Salmon10k/Pocketpet.esp32c3/Simulations/fluid 1.webp

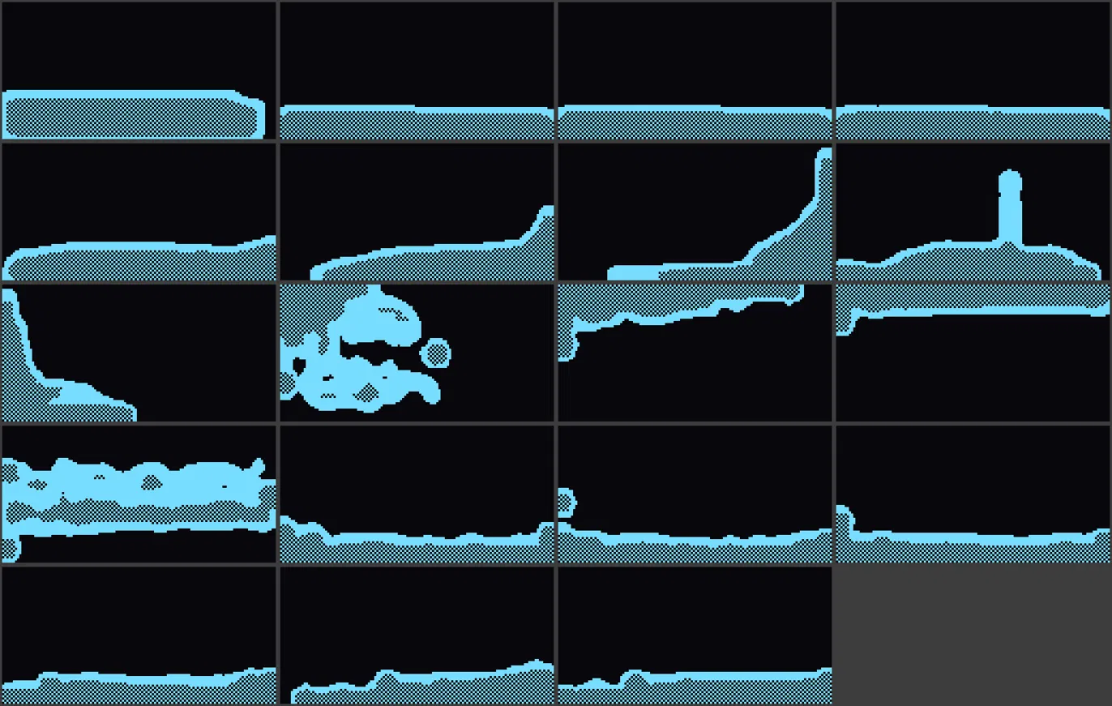
Simulations/fluid 1.webp
