Salmon10k/Pocketpet.esp32c3/Simulations/fluid 3.webp

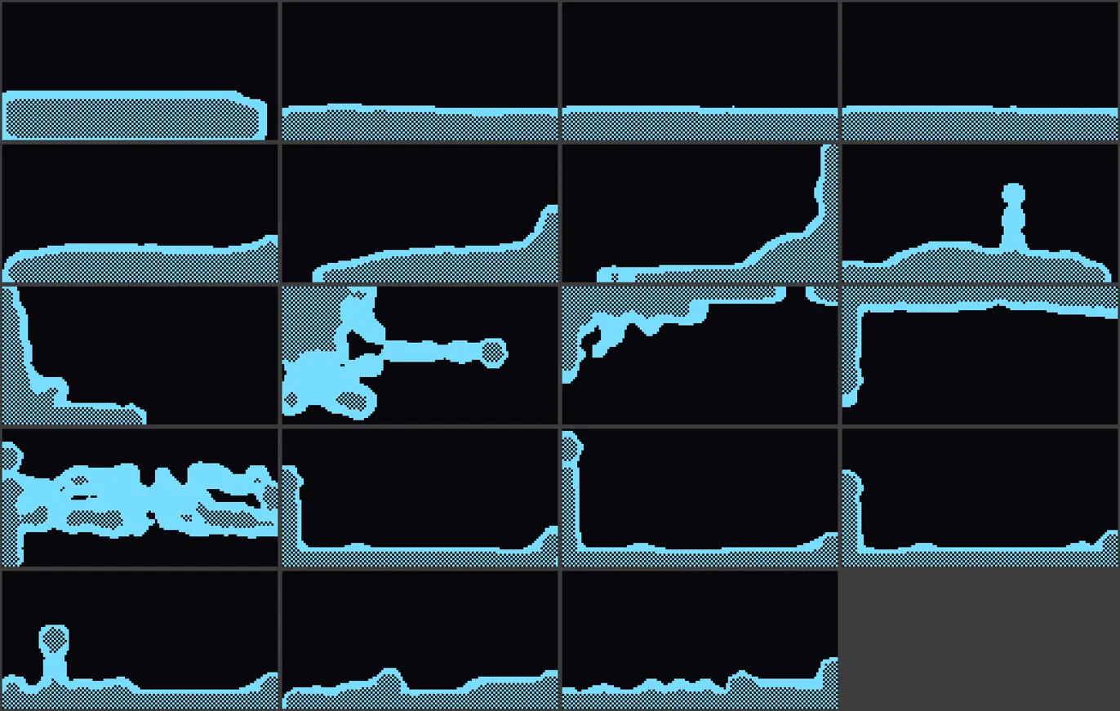
Simulations/fluid 3.webp
