Salmon10k/Pocketpet.esp32c3/README.md

# Pocketpet.esp32c3

> **Status (2026-11-14): active again, in small steps.** The project was paused on 2026-10-30 and picked back up
> for the games/menu revamp (11-12) and a repo review (11-14). A lot of the firmware on `main` (Online, Spotify,
> Lyrics visual, games, launcher) is still **not fully tested on the device**, and the custom PCB is designed but
> not finished or ordered (`PCB/` holds the KiCad project only). See `HANDOFF.md` for the details.
> Do not start big new features unless Salman asks.

Keychain-sized digital pet gadget built around an ESP32-C3 Super Mini with a 1.3" SH1106 OLED, MPU6050 motion sensor, touch input and three buttons.

## Current hardware wiring

**Important:** the OLED and MPU6050 share **one hardware I2C bus (`Wire`)** on GPIO 8 (SDA) and GPIO 9 (SCL), 400 kHz. They have different addresses (OLED `0x3C`, MPU6050 `0x68`), so they coexist on the same two wires. (Until 2026-11-09 the MPU6050 was on its own software I2C bus on GPIO 5/6; that is gone and GPIO 5/6 are free.)

| Part | Pin | ESP32-C3 GPIO | Notes |
|---|-----|---|---|
| OLED SH1106 + MPU6050 | SDA | **8** | Shared hardware I2C, 400 kHz |
| OLED SH1106 + MPU6050 | SCL | **9** | Shared hardware I2C, 400 kHz |
| Button A | one leg to GND | **2** | Up / previous / tickle |
| Button B | one leg to GND | **1** | Select / back |
| Button C | one leg to GND | **0** | Down / next / boop |
| Touch pad | OUT | **4** | TTP223-style, HIGH when touched (the pin next to 3V3) |

Wire the MPU6050 SDA/SCL to the same GPIO 8 / 9 pins as the OLED.

### I2C addresses
- OLED: `0x3C`
- MPU6050: `0x68`

### GPIO notes
- GPIO 8 and GPIO 9 are ESP32-C3 strapping pins (they are also the C3's default I2C pins). The OLED has been tested on them. If the board ever becomes unreliable during boot, investigate these pins first.
- GPIO3 is the only free ADC1 pin left. Keep it for the battery voltage divider.
- GPIO 0-5 can wake the C3 from deep sleep, so the touch pad (GPIO4) and buttons (0, 1, 2) all work for wake-up later.

## Current firmware

### Home and menu
The **pet is the home screen**: it is what you see when the keychain turns on and where it returns to when you leave it alone (the launcher goes back to the pet after 20 s without input; holding B in the launcher also goes home). **Press B on the pet** to open the launcher, which has two styles you pick in **Settings > Menu style**:
- **Carousel** (default): big icons slide in from the right; **A** = previous, **C** = next, **B** = open.
- **Tilt ring**: the apps sit on a ring; **tilt the keychain toward an app** to highlight it, **B** opens it (A/C also step through them).

In the launcher: Fluid, Stats, Motion test, Tools, Games, Online, Spotify, Visualizer (Lyrics visual), Living OLED, Settings. While it starts, the MPU6050 calibrates itself in the background (gyro offsets, and which way is "down" from gravity), so tilt works however the sensor sits on the board and however you hold the keychain; in Pet mode it re-levels itself when you hold it still in a new pose. Every sub-menu (Tools, Games, Settings and the Online list) uses the same carousel / tilt-ring look as the home screen: **A/C** move, short **B** opens, **hold B** goes up one level, and each one ends with a **Back** item. Settings shows the current value in a pill under the name (brightness, screen auto-off, flip screen, menu style, lyrics sync, reset pet); Games shows your best score. Tools contains Temperature, Magic 8-ball and Dice (shake the keychain to roll / ask).

### Games
Built for the three buttons and the MPU6050. Best scores are saved.

| Game | Controls |
|---|---|
| **Star Blaster** (side-scrolling shooter: drones, gunships, splitting rocks, power-ups) | tilt flies the ship, **A** shoots (hold = rapid fire), **C** = smart bomb |
| **Sniper** (night city, scope with sway; enemies pop up in windows, survive 3 misses) | tilt swings the scope, **A** fires (bolt action), hold **C** to steady your breath and zoom 2x |
| **Road Rush** (pseudo-3D racer, beat the clock, checkpoints add time) | tilt steers (bends push you outwards), **A** nitro, **C** brake |
| **Pinball** (the table lies on its side, flippers on the right edge) | **A** upper flipper, **C** lower flipper, shake the keychain to nudge the ball (nudge too much = TILT) |
| **Tilt Maze** | tilt, **A** re-zero, **C** new maze |
| **Snake** | tilt to steer (or **A** left / **C** right) |

Online has 12 screens that need the internet (see below). Copy `src/secrets.example.h` to `src/secrets.h` and set `WIFI_SSID` / `WIFI_PASSWORD` locally first. The touch pad only works in Pet mode.

### Online mode
Wi-Fi stays **off** everywhere except Online mode. Entering Online connects **once** (up to 3 automatic attempts, then each request is retried up to 3 times for random network hiccups), fetches everything for every screen in one go, and stays connected while you browse. Leaving Online switches the radio off. The list header shows the state: `wifi 2/3`, `sync 4/9`, `online`, `offline`. Every screen shows how old its data is (top right). If a refresh fails you keep the last good data.

**Several Wi-Fi networks:** list them in `secrets.h` with `WIFI_NETWORKS` (see `src/secrets.example.h`), for example home, uni and your phone hotspot. On entering Online it scans, tries the strongest known network first and falls back to the others by itself. Net status shows which one it picked. 2.4 GHz networks only.

Controls: in the list, A/C move and B opens (**Sync now** refetches everything, **Back** leaves). On a screen, **A = refresh this screen** (no reconnect), **C = next screen**, **B = back to the list**, touch = Home.

| Screen | Source (no API keys) | Refreshes |
|---|---|---|
| Clock | NTP (`pool.ntp.org`), keeps ticking offline | synced on connect, resync every 6 h |
| Weather | Open-Meteo | 30 min |
| Forecast | same request as Weather | 30 min |
| Air quality | Open-Meteo air quality (US AQI, PM2.5) | 30 min |
| Currency | open.er-api.com (USD to `CURRENCY_HOME`, EUR, GBP) | 6 h |
| World clocks | computed from NTP time, with DST rules for London, New York, Tokyo, Sydney | no request |
| Random fact | uselessfacts.jsph.pl | once per visit, A = new one |
| Advice | adviceslip.com | once per visit, A = new one |
| Moon phase | calculated from the date (approximate, within about a day) | no request |
| Net status | RSSI, IP, a `generate_204` check with ping time | every 20 s while open |
| ISS tracker | api.open-notify.org (plain HTTP) | every 60 s while open |
| GitHub | api.github.com stars, forks, issues, last push | 10 min |

Location for weather and air quality comes from an IP lookup (ip-api.com) unless you set `LOCATION_LAT` / `LOCATION_LON` in `secrets.h`. See `src/secrets.example.h` for all optional overrides.

**Pet reactions:** when cached data exists, Pet mode shows tiny corner icons: sweat drop (35 C or hotter), umbrella (rain chance 60% or more), cloud (AQI 150 or more), moon (after sunset). Each successful fetch also gives the pet a small happiness bump.

Requests are blocking with a 7 second timeout, so the screen can pause briefly while one runs. A progress frame is drawn first so it never looks frozen. Background refresh while you are in Online: weather and air quality every 30 min, currency 6 h, GitHub 10 min. Net status and ISS only refresh while you are looking at them.

**Connection problems:** many ESP32-C3 Super Mini boards fail to connect at full TX power, so the firmware lowers it to 8.5 dBm by default. If your router is far away and the signal is weak, put `#define WIFI_TX_POWER WIFI_POWER_11dBm` (or `WIFI_POWER_19_5dBm`) in `src/secrets.h`.

### Spotify mode
Shows what is playing on your Spotify (any device: phone, PC, speaker), with **synced lyrics** from LRCLIB, and controls it: **A** previous, **B** play/pause, **C** next. **Hold B** (0.7 s) = back to the menu. The screen stays on while you are in this mode. Needs Spotify **Premium** for the buttons (viewing works without) and the Wi-Fi from `secrets.h`. Spotify itself must be playing somewhere; the keychain is a remote, not a speaker.

One-time setup (on your PC):
1. https://developer.spotify.com/dashboard -> Create app (any name, Web API). Add the Redirect URI exactly `http://127.0.0.1:8888/callback`. Copy the Client ID.
2. `python tools/spotify_auth.py YOUR_CLIENT_ID --write` (opens a Spotify login page, then writes `SPOTIFY_CLIENT_ID` and `SPOTIFY_REFRESH_TOKEN` into `src/secrets.h`, which Git ignores).
3. Build and flash. If it says the login expired (about every 6 months), run step 2 again.

Notes: Spotify apps in development mode need the app owner to have Premium and allow 5 users, which is plenty for one keychain. The screen can freeze for about a second when a song changes (a new secure connection for the lyrics), that is normal. Not every song has synced lyrics; those show the title and artist instead.

### Fluid mode
Particle water simulation that follows tilt. Hold the device like a phone, it calibrates for half a second (that pose counts as level). A = re-zero, C = Water / Honey / Mercury, B = back.

### Pet mode (companion style, nothing can die)
- Eyes ease smoothly between moods, blink on their own, sometimes double-blink or wink, and wander around when idle.
- Pupils follow tilt from the MPU6050.
- **Moods:** neutral, happy, sad (when ignored), sleepy (low energy or no activity for 30 s), asleep (no activity for 60 s, with floating Zzz).
- **Touch:** tap = love face and hearts. Hold the pad for 0.6 s = purr, which keeps raising happiness.
- **Motion:** shake = dizzy spiral eyes (and a small happiness drop). A sharp pickup, bump or drop = surprised.
- **Buttons in Pet mode:** A = tickle (laughs), C = boop (surprised), B = back to the menu.
- Any touch, button press or movement wakes it up.
- **Music pet (Settings > Music pet, default On):** while Spotify is playing, Pet mode quietly opens a Spotify session (Wi-Fi, so it costs battery; it drops when the screen turns off or you leave Pet mode) and the pet dances to the song. The reaction depends on the vibe: **Chill** (eyes closed, headphones, slow sway), **Pop** (happy eyes, bounce, notes and sparkles), **Hype** (shades, head nods, impact lines), **Rock** (angry eyes, headbang, lightning), **EDM** (big pulsing pupils, equalizer, strobe on the bar), **Desi** (dreamy eyes, wide sway, hearts), **Dreamy** (starry eyes, twinkles). The mouth flaps on sung words. The vibe name flashes briefly when a track starts; a trailing **?** means it was guessed (no genre data) from the title and lyric speed. The beat is a steady feel-tempo per vibe locked to the song position, not the song's real BPM (Spotify no longer gives tempo).

### Stats
Happiness and energy are saved to flash (about every 2 minutes when they changed, and when leaving Pet mode), so the pet remembers across reboots. The Stats screen shows both bars and a lifetime pet count. **A or C flips it to a System page** with the numbers that matter for debugging: FPS (frames sent to the OLED, capped at 25), how often `loop()` runs, free heap, lowest free heap since boot, the largest free block (the real limit for a TLS connection), app size, uptime and why the chip last restarted. Open it before and after using Online or Spotify to see how much heap they eat.

### Other
- Button debouncing with press events.
- MPU6050 and OLED are re-checked every 2 seconds and recover if they drop out.
- Serial diagnostics once a second (buttons, touch, OLED, MPU, happy, energy, pets, fps, free / min heap and largest free block in KB).
- GitHub Actions (`.github/workflows/build.yml`) builds the firmware with PlatformIO on every push and shows the RAM / flash usage in the run summary.

## Build

1. Install PlatformIO in VS Code.
2. Open this folder (it will download U8g2 and ArduinoJson).
3. Plug the ESP32-C3 Super Mini in with a data-capable USB cable.
4. Build and upload with PlatformIO.
5. Board environment: `esp32-c3-supermini`.
6. USB CDC on boot is enabled in `platformio.ini`.
7. `partitions.csv` gives the app a 3 MB slot (no OTA) because Wi-Fi + TLS made the firmware too big for the default 1.3 MB slot.

## Files
- `src/main.cpp` -> main firmware and pet logic
- `src/online.h` / `src/online.cpp` -> Online mode (Wi-Fi state machine, request cache, the 12 screens)
- `src/vibe.*` -> genre to vibe classification, feel-tempo, energy (pure C++)
- `src/pet_face.*` / `src/pet_music.*` -> pet eyes and mouth drawing; per-vibe dance poses and decorations
- `src/spotify.h` / `src/spotify.cpp` -> Spotify mode (token refresh, now playing, controls, LRCLIB lyrics)
- `tools/spotify_auth.py` -> one-time Spotify login helper (PC)
- `src/config.h` -> all GPIO assignments, I2C addresses and pet tuning
- `platformio.ini` -> PlatformIO build configuration
- `partitions.csv` -> flash layout (one 3 MB app slot)

When changing wiring, update `src/config.h` first.

## First-flash checklist
- [ ] Builds and uploads
- [ ] OLED shows the menu (serial boot log says "OLED found")
- [ ] Serial shows `mpu=1`
- [ ] `touch=` flips to 1 when the pad is touched
- [ ] Eyes follow tilt the right way (if not, flip `TILT_X_SIGN` / `TILT_Y_SIGN` in `config.h`)
- [ ] Shake gives dizzy eyes, sharp pickup gives surprised eyes

## Status
- [x] Repo + starter project
- [x] OLED confirmed working (SH1106, GPIO 8/9)
- [x] Touch pad soldered on, signal on GPIO4
- [x] I2C roles swapped: OLED on hardware I2C, MPU6050 on SoftWire (superseded 2026-11-09: both now share the hardware bus on GPIO 8/9)
- [x] Improved pet mode: moods, eased eyes, touch petting, motion reactions, sleep, hearts, Zzz
- [x] Stats screen with flash-saved happiness and energy
- [x] Verify current firmware on hardware
- [ ] Try the RoboEyes library for the eyes (optional, only if the current look is not liked)
- [x] Temperature mode
- [x] Game mode (Magic 8-ball + Dice)
- [x] Games (Star Blaster, Sniper, Road Rush, Pinball, generated Tilt Maze, tilt Snake)
- [x] Touch pad (Pet mode only)
- [x] Optional Wi-Fi NTP clock (credentials must be configured locally in ignored `src/secrets.h`)
- [x] Wi-Fi NTP clock
- [x] Online mode: weather, forecast, AQI, currency, world clocks, fact, advice, moon, net status, ISS, GitHub (in code, host-checked, not yet tested on the device)
- [ ] Pet sleeps at night
- [ ] Battery monitoring (GPIO3 divider)
- [ ] Deep sleep / wake on touch

## Notes for future development

> **OLED + MPU6050 share one hardware I2C bus on GPIO 8 (SDA) / 9 (SCL).**

If another developer or AI agent continues this project, read `src/config.h` and this README before changing pin assignments or the bus setup. The pet logic is separated from the drawing: `currentFace()` decides the mood, `faceParams()` maps a mood to eye/mouth targets, and `drawPet()` eases toward them.

## Work completed today (2026-10-10)

Today’s development session focused on expanding the games and preparing the online clock feature:

- **Tilt Maze:** planned/prototyped a procedural maze system, with randomized maze generation, solvable layouts, reversed left/right tilt behavior, and a 45° forward-facing MPU6050 neutral angle.
- **Dino Runner:** expanded the design with jump/crouch controls, additional obstacle types, flying obstacles, and more polished movement/animation.
- **Online clock:** added the Wi-Fi/NTP clock direction, including local credential handling through the ignored `src/secrets.h` file and an example template at `src/secrets.example.h`.
- **Documentation:** updated the handoff notes and README to record the work from this session.

**Hardware status:** these new changes were not fully hardware-validated today. The existing Batch 1 hardware features remain the known-tested baseline. Do not treat the new maze, Dino upgrades, or Wi-Fi clock as hardware-confirmed until they are built, flashed, and tested on the device.
