Salmon10k/Pocketpet.esp32c3/HANDOFF.md

# HANDOFF: read this first if you are an agent (or human) continuing the project

## Project paused (2026-10-30), active again in small steps (2026-11-12 and 2026-11-14)
Salman paused the project. On 2026-11-12 he asked for a games + menus revamp (see "Games and menu revamp" at the
bottom); that is done in code and host-tested, not yet flashed. On 2026-11-14 he asked for a repo review and for the
small quick fixes first (see "Review fixes 2026-11-14" at the bottom). Do not start big new features or refactors
unless he asks; he is choosing from a list of ideas (battery gauge, night sleep, deep sleep, ...).

**State when paused**
- Firmware on `main` (last commit before the pause: `b2318d5`, word timing in lyric lines). Hardware is the
  protoboard build (ESP32-C3 Super Mini, SH1106 OLED, MPU6050, touch pad, three buttons). The TP4056 charger
  module was found faulty (0.45 V drop under load), so the battery was not reattached; a protected
  replacement was still to be bought.
- Tested on the device: pet mode, stats, I2C swap, touch, Temperature, Magic 8-ball, Dice.
- Written and host-checked only, never confirmed on hardware (see the Status table and the per-feature notes
  below): Online mode, Spotify mode and its lyric worker, Lyrics visual, Quick connect, Wi-Fi fixes,
  Urdu/Arabic lyrics, word timing, Snake, Tilt Maze, Fluid, Settings, the new games and launcher. (Flappy, Dino Runner
  and Catch Water were removed on 2026-11-12.)
  The `feature/lyrics-visualizer` branch history is described below; check `git branch -a` before assuming
  it was merged.
- Custom PCB: a ghost-shaped KiCad board was designed but is not finished or ordered. NOTE (2026-11-14): the
  `pcb/README.md` that used to describe it (outline SVG, KiCad placement script, layout coordinates and a list of
  schematic problems, including the battery connector wired to the wrong net) is NOT in the repo any more; `PCB/`
  only holds the raw KiCad files (`PCB.kicad_sch/pcb/pro/prl`). Check the schematic's battery connector net before
  ordering anything.
- Not started: battery monitoring (GPIO3 divider), deep sleep with wake on touch, Pomodoro/Stopwatch,
  Spirit level, Step counter, pet sleeps at night.

**To resume**
1. Ask Salman what he wants first. The safest start is to build with PlatformIO, flash, and report the
   serial log and memory numbers for the untested modes.
2. For the PCB, open `PCB/PCB.kicad_pro` in KiCad (the old `pcb/README.md` notes are gone, see above).
3. Keep the rules below (do not change pins, keep the pet animation code, no secrets in the repo).

Owner: Salman (GitHub: Salmon10k). Student, new to soldering, builds on a protoboard, flashes with
PlatformIO in VS Code on Windows. He tests on the real device and reports back, so keep instructions short
and concrete. Casual tone is fine and preferred. He is on a free Claude plan with limited usage, which is
why this file exists.

## What this is
Pocketpet: a keychain-sized ESP32-C3 Super Mini gadget with a 1.3" SH1106 128x64 mono OLED, MPU6050
(accel/gyro/temp), a TTP223 touch pad, 3 buttons and a battery. Main feature is an animated pet; more
"modes" (tools, games, WiFi clock) are being added around it.

## Hardware map (source of truth: `src/config.h`)
| Part | GPIO | Notes |
|---|---|---|
| OLED + MPU6050 SDA/SCL | 8 / 9 | ONE shared HARDWARE I2C bus (`Wire`), 400 kHz; OLED 0x3C (U8g2 `..._F_HW_I2C`), MPU6050 0x68 (raw register reads). Changed from separate buses (MPU on SoftWire GPIO 5/6) on 2026-11-09 at Salman's request; GPIO 5/6 are now free. |
| Button A / B / C | 2 / 1 / 0 | to GND, internal pull-up, active LOW. Matches `config.h` (docs used to say A=0, C=2; fixed 2026-11-14, Salman should confirm on the board) |
| Touch pad OUT | 4 | HIGH when touched |
| Free ADC pin | 3 | reserved for the battery voltage divider |

Do NOT change the bus layout or pins without asking Salman: the board is soldered, rewiring is painful.
GPIO 8/9 are strapping pins, GPIO 0-5 are the only deep-sleep wake pins on the C3.

## Source layout
- `src/config.h`: pins, addresses, timing and tuning macros.
- `src/online.h` / `src/online.cpp`: the whole Online mode. Own state (Wi-Fi state machine, per-request cache, 12 screens). main.cpp only calls `online::enter/leave/tick/input/draw/drawPetBadge/takeTreats`. See "Online mode" below.
- `src/spotify.h` / `src/spotify.cpp`: Spotify mode (MODE_SPOTIFY, root menu index 7). Borrows the radio from online.cpp through `online::wifiAcquire/wifiRelease/wifiUp/wifiStatusText`; online's tick drives the connection while `wifiHold` is set, but runs no jobs unless `session` (Online mode) is open.
- `src/vibe.h/.cpp` (pure C++), `src/pet_face.h/.cpp` (eye/mouth drawing moved out of main.cpp), `src/pet_music.h/.cpp` (poses + decor per vibe): the Music pet. Tools: `tools/vibetest/` (248 checks), `tools/petpreview/` (real face on PC + ASan torture). See "Music pet" below.
- `tools/spotify_auth.py`: PKCE login helper run on the PC, writes SPOTIFY_CLIENT_ID / SPOTIFY_REFRESH_TOKEN into secrets.h.
- `src/games.h` / `games.cpp`: Star Blaster, Sniper, Road Rush, Pinball (self-contained; main.cpp hands in an `Input` struct with buttons, calibrated tilt and shake, and owns the tilt calibration).
- `tools/gamepreview/`: PC harness (real U8g2 on the PC) that renders menus/games to PNG sheets, runs scripted "AI players" and a sanitizer fuzz test. See "Games and menu revamp".
- `src/launcher.h` / `launcher.cpp`: the home menu AND every sub-menu (carousel + tilt ring, `enterSub()` with any item list, optional value pill), 37 procedural icons (`drawIcon`, any size/animated), selection state. Pure UI: main.cpp starts the apps. `src/gfx.h` / `gfx.cpp`: clipped primitives (px/line/circle/disc/arc/rframe...) that are safe at any coordinate (U8g2 coordinates are unsigned 8-bit).
- `src/main.cpp`: current firmware, hardware init, input handling, MPU, stats, pet animation/drawing, menus and mini-games, shared tilt helper, Tilt Maze, Fluid glue.
- `src/fluid.h` / `src/fluid.cpp`: fixed-point particle fluid (no Arduino deps, also compiled on PC by `tools/fluidtest/`).
- `tools/fluidtest/`: host harness (`fluidtest.cpp` + `render.py` PNG contact sheets) for tuning the fluid without hardware.
- `src/config.h`: hardware pins and tuning.
- The firmware is currently monolithic in `main.cpp`; do not assume the planned screen-registry/multi-file architecture exists yet.
- `README.md`: user-facing docs. Keep it in sync when behaviour changes.

## Architecture: screens
Current implementation uses a `Mode` enum and dispatches input/drawing in `main.cpp`. The menu tree has root, Tools, Games and Online. Rules:
- Modes draw into the shared `display` buffer; the main loop does `clearBuffer()` / `sendBuffer()`.
- Convention: **B = back/exit**, A and C are actions. The touch pad acts as Home outside Pet mode.
- Anything that must keep running outside its screen (Pomodoro timer, step counting, WiFi state machine)
  has a `xxxTick(now)` function that the main loop calls every iteration.
- Use `notify("text", ms)` for a banner shown over any screen (e.g. "Pomodoro done").
- Never block the loop for long. The only accepted blocking call is the weather HTTP GET (short timeout).
- Pet stats are changed through `petAddHappy()` / `petAddEnergy()`, never directly from other files.

## Conventions
- Companion pet: nothing can die, stats are floored. Do not add punishing mechanics.
- Flash saves go through `Preferences` ("pocketpet" namespace), throttled. Do not write to flash in a loop.
- No secrets in the repo (the repo is public). WiFi credentials and the user's coordinates live in
  `src/secrets.h`, which is gitignored; `src/secrets.example.h` is the template. Never commit `secrets.h`.
- Commit messages in this repo end with the Co-Authored-By / session trailers the harness asks for.
- Memory numbers: the first pet version was RAM 4.9%, flash 23.1% of the default 1.3 MB app slot. After Online mode (Wi-Fi + TLS + ArduinoJson) Salman reported about 21% flash left, i.e. roughly 79% used of the 1.3 MB slot. So `platformio.ini` now uses `partitions.csv` (one 3 MB app slot, no OTA, nvs at the same address so saved stats survive). The first upload after that change rewrites the partition table. Serial prints one `flash: app ... heap free ...` line in the boot log and a heap line after each Online sync: ask Salman for those numbers before deciding to cut features. Latest build (2026-11-14, PlatformIO summary): RAM 31.7% (103,772 of 327,680 bytes, static), flash 36.0% (1,133,192 of 3,145,728 bytes). Runtime heap is on Stats > System (press A on Stats) and in the serial status line.

## Testing (important)
- In the agent sandbox PlatformIO cannot download the ESP32 toolchain, so NOTHING can be compiled for the
  chip there. Run `tools/hostcheck/check.sh` instead (it has mock WiFi.h too): it syntax-checks every `src/*.cpp` against mock Arduino
  headers plus the real U8g2 / ArduinoJson headers. Passing means "no typos / API mismatches",
  not "works on the board".
- Salman builds with PlatformIO (check mark), flashes (arrow) and watches Serial Monitor at 115200.
  Ask him for build output / serial log when something fails. Each batch of work should end with a short
  "what to test on the device" list for him.
- Serial prints a status line every second (buttons, touch, oled, mpu, happy, energy, pets).

## Status
Update this section as you work. Mark things DONE only after the host check passes; mark TESTED only after
Salman confirms on the device.

| Item | State |
|---|---|
| Pet mode (moods, touch, shake, sleep), Stats, Motion test | DONE and TESTED (Salman: "looks good") |
| I2C swap (OLED hw, MPU soft), touch on GPIO4 | DONE and TESTED. SUPERSEDED 2026-11-09: both now on one hardware bus GPIO 8/9 (host-checked only, not yet flashed) |
| Expanded root/Tools/Games/Online menus | DONE (monolithic implementation) |
| Temperature, Magic 8-ball, Dice | DONE and TESTED (Salman confirmed) |
| Games: Star Blaster, Sniper, Road Rush, Pinball (games.cpp), tilt Snake, Tilt Maze; Flappy / Dino / Catch Water removed | DONE in code + host-checked + PC-rendered + fuzzed (2026-11-12); needs Salman hardware confirmation |
| Tools / Games / Settings / Online list in the launcher look (carousel or tilt ring, Back item, value pills) | DONE in code + PC-rendered; needs hardware confirmation |
| Fluid main mode (root menu item 2), 3 presets | DONE in code + host-checked + host-rendered; needs Salman hardware confirmation (FPS, tilt feel) |
| Tilt Maze rewrite (fixed 20 ms physics, shared tilt helper) | DONE in code + host-checked; needs hardware confirmation |
| Pomodoro + Stopwatch | TODO (batch 3) |
| Online mode (12 screens: Clock, Weather, Forecast, Air quality, Currency, World clocks, Fact, Advice, Moon, Net status, ISS, GitHub) | DONE in code + host-checked; needs Salman hardware confirmation (never compiled for the chip) |
| Pet corner badges from Online data (hot, rain, smog, night) | DONE in code, needs hardware confirmation |
| Pet sleeps at night | TODO (Online already stores `is_day`, see `online::petHint()`) |
| Spirit level, Step counter | TODO (batch 5) |
| BLE shutter remote | SKIPPED by Salman for now (do not build unless asked) |
| Battery monitoring (GPIO3 divider), deep sleep + wake on touch | NOT STARTED, needs hardware first |

## Currently working on
Online mode just landed (host syntax check passes, nothing compiled for the chip or flashed). Next: Salman flashes it and reports, then Pomodoro/Stopwatch, Spirit level, Step counter.

### Online mode (online.cpp)
- **Items vs jobs.** 12 screens ("items") map to 10 network "jobs" (geo, weather, aqi, currency, fact, advice, net, iss, crew, github). Forecast reuses the weather job; Clock/World/Moon only need NTP time.
- **Radio policy: ONE session per visit.** `enter()` queues every job (`queueSync`) and connects once; `leave()` switches the radio off. Nothing else touches Wi-Fi, and Pet/other modes never turn it on. Networks come from `WIFI_NETWORKS` (several) or `WIFI_SSID/WIFI_PASSWORD` (one) in secrets.h: with several, an async scan runs first (`W_SCAN`) and `buildOrder()` sorts the known ones by signal; each network gets 2 attempts (min 3 total, max 8). Connect attempts are 10 s each with 1 s backoff, `WiFi.setTxPower(WIFI_TX_POWER)` defaults to 8.5 dBm (known fix for flaky C3 Super Mini antennas, overridable in secrets.h). Link drop while in Online reconnects by itself and keeps the queue. `tick()` runs at most one request per call, only after a frame was drawn; transient failures (HTTP <= 0 or >= 500, bad JSON) retry up to 3 times. After the initial sync, `autoRefresh()` re-queues stale jobs every 3 s (Net/ISS only while that screen is open; a failed refresh waits 60 s). Do not add per-screen `WiFi.begin()` calls.
- **Time.** System time is UTC (`configTime(0,0,...)`), then `TZ` is set from `LOCAL_TZ` (default `PKT-5`). Clock keeps ticking with the radio off. World clocks compute offsets with their own DST rules (EU, US, AU). Do not call `configTime` elsewhere with an offset, it resets TZ.
- **Cache.** Each job has `at/has/err/http`. Failed refresh keeps old data and shows `!` in the header tag. Intervals live in `JOB_EVERY[]`.
- **Location.** `LOCATION_LAT/LON/NAME` in secrets.h, else one IP lookup per boot (ip-api.com, HTTP). No city or coordinates are committed.
- **Controls.** List: A/C move, B opens; extra rows "Sync now" (refetch everything) and "Back". Inside a screen: A = refresh that screen's jobs (ignored within 1.5 s of the last one), C = next screen, B = back to list, touch = Home (existing global rule).
- **Pet hook.** `online::petHint()` reads cached data only; `drawPetBadge()` is drawn after `drawPet()` in main.cpp, `drawPet()` itself is untouched. `takeTreats()` gives +1 happiness per completed sync.
- **Known approximations.** Moon phase uses the mean synodic month (can be off by up to about a day). `setInsecure()` TLS. ISS/crew use open-notify (HTTP only, free service, may be down; failure just shows "Couldn't load").

### What Salman should test on the device (Online)
1. Build with PlatformIO (it will download ArduinoJson). Send me the build output if it fails; I could not compile for the chip.
2. Copy `src/secrets.example.h` to `src/secrets.h`, set SSID + password, flash.
3. Online: the list header should go `wifi 1/3` > `sync n/9` > `online`, all with ONE connection. Clock shows PKT time.
4. Weather / Forecast / Air quality: city comes from the IP lookup, values look sane. Press A to refresh.
5. Currency, World clocks (compare with a phone), Moon, Net status (RSSI, IP, ping), ISS dot moves between refreshes, GitHub shows your repo.
6. Fact / Advice: A gives a new one, long ones scroll.
7. With Wi-Fi off or a wrong password: a screen should say "Couldn't load / No Wi-Fi", not freeze.
8. Pet mode after fetching weather: no icon is normal unless it is 35 C+, rainy, AQI 150+ or night.
9. Free heap / flash: check the PlatformIO memory summary after the build and tell the next agent.

### Spotify lyric stutter fix (2026-10-11; not yet hardware-validated)

**Goal:** keep lyric sliding/highlighting animated while Spotify or LRCLIB HTTPS requests are slow. The animation and its drawing algorithm were not changed.

**Exact files changed for this fix**
- `src/spotify.cpp`
  - Added a persistent FreeRTOS task named `spotifyNet` with a 16 KB stack.
  - `spotify::tick()` now queues one of four network jobs: login, now-playing poll, lyric lookup, or playback command. Those HTTPS calls run on `spotifyNet`, not the Arduino loop that draws the OLED.
  - Added a recursive mutex around short shared-state operations and the Spotify draw/input functions. The mutex is not held during HTTP requests.
  - Added a session-generation counter so responses that finish after leaving/re-entering Spotify are discarded.
  - The TLS client is now owned/cleaned up by the worker. `leave()` no longer calls `sec.stop()` while a request could be using the client.
  - Existing lyric animations, timings, fonts, line parsing, poll intervals, credentials, controls, and network endpoints were left as they were.
- `tools/hostcheck/freertos/FreeRTOS.h`, `task.h`, `semphr.h`
  - Added syntax-only mocks for the task and recursive-mutex APIs. They are not real FreeRTOS implementations and do not test scheduling.
- `HANDOFF.md`
  - This rollback/change note only.

**Not changed:** `src/main.cpp`, `src/online.cpp`, `src/spotify.h`, `src/config.h`, README, pin assignments, pet animation code, or secrets.

**Validation status:** source changes are committed, but a PlatformIO ESP32-C3 build and on-device playback test have **not** been run by the agent. Host syntax checks are useful but cannot confirm task stack sizing, heap headroom, Wi-Fi behavior, or race-free playback on hardware. First test: build with PlatformIO, flash, then watch whether lyrics keep animating during a poll and during a track change. If the screen says `Network task unavailable`, the worker task or mutex could not be created.

**Commits in this change**
- Spotify worker/state-locking implementation: `aeea5775ee4005358710d89c6ea9d4e02b13987f`
- Host-check mock headers: `f4208e5f4561731020b57d1535936d9882cb83d3`, `e96ad10dbbe40e473b74e79b94f6b71aff11e7eb`, `0496876a6007b276334382a86e0ff30719d19704`
- Pre-change rollback point: `d94f61cb9bf372f5fc9533e8a86e69632073006f`

**Rollback:** use `git revert --no-edit` on the commits above in reverse order, including the HANDOFF note commit once its SHA is recorded in the commit history. The simplest clean reference for the original animated-lyrics code is `d94f61cb9bf372f5fc9533e8a86e69632073006f`. Do not reset/force-push if there are later commits you want to keep.

### Spotify visual polish V2 (2026-10-11; review on hardware)

**Goal:** give the 128x64 Spotify lyrics screen a calmer, more intentional hierarchy without changing its signature animated transitions.

**Exact change**
- File changed: `src/spotify.cpp` only for the implementation.
- In `drawBig()`, removed the dotted/solid underline drawn under every lyric row. Word-by-word inverted highlighting remains unchanged, reducing visual clutter.
- Added `drawNextPreview()`: upcoming lyric now has a small `NEXT` label, with text centered in a reserved right-hand area.
- In `drawLocked()`, added a thin divider under the header and a divider above the upcoming-line preview.
- Reworked the overall track progress line into a dotted unplayed rail, solid elapsed segment, and small vertical playhead.
- No changes to HTTP/network worker, LRC parsing/timing, animation durations, lyrics fonts, input controls, `main.cpp`, `online.cpp`, hardware configuration, pet animations, or games.

**Commit**
- Visual polish: `55e2b7309434ca76495d61d5789ac503f6253267`
- Pre-polish rollback point: `cb49a9592411ab5c74fb525116a606deed187798`

**Validation:** no PlatformIO build or hardware check has been run for this visual-only change yet. Build and flash, then inspect short lyrics, long lyrics (2-3 rows), instrumental gaps, and the next-line preview. Confirm the new `NEXT` label does not overlap the incoming lyric during slide transitions and the bottom playhead is visible but not distracting.

**Rollback if the appearance is worse:** revert `55e2b7309434ca76495d61d5789ac503f6253267` to restore the prior Spotify visuals while keeping the earlier non-blocking network worker. The following HANDOFF-only commit documents this change and can also be reverted; do not revert the network-worker commits unless intentionally rolling back the stutter fix too.

### Spotify mode (spotify.cpp)
- Auth: refresh token (from secrets.h, rotated copy kept in NVS namespace `spotify`, ignored when secrets.h holds a different token) -> access token (1 h) refreshed quietly. 400/401 on refresh = "Login expired".
- Polls `GET /v1/me/player/currently-playing` every 4 s (8 s paused), interpolates the progress between polls. Commands (play/pause/next/previous) are blocking requests run from tick() after one frame is drawn; the pause button flips the UI optimistically and undoes it on failure. 403 = no Premium, 404 = no active device.
- Lyrics: LRCLIB `/api/get` (exact title+album+duration, then cleaned title without album). Parsed LRC lives in static arrays (160 lines, 7 KB pool), converted from UTF-8 to Latin-1 for the `_tf` fonts. Fetch happens once per track; network errors retry up to 3 times, 404 = "no synced lyrics".
- One reused `WiFiClientSecure`; any non-200 answer closes the connection. Requests are refused below 55 KB free heap.
- Loop task stack raised to 16 KB with `SET_LOOP_TASK_STACK_SIZE` (guarded by `#if defined`).
- Host check covers syntax; the pure helpers (toLatin1, urlEncode, cleanTitle, parseLrc, wrapText) were tested on the PC by extracting them. NOT tested on hardware or against the live Spotify API: HTTPClient keep-alive, the 204 handling and the Content-Length: 0 on PUT/POST are the first things to check if something fails.

### What Salman should test on the device (Spotify)
1. Do the one-time setup in README ("Spotify mode"), build, flash.
2. Menu > Spotify: `wifi` > `logging in` > now playing within a few seconds, with Spotify playing on his phone.
3. B pauses and resumes, A/C change songs, the progress bar follows.
4. Lyrics highlight the right line; compare timing with the Spotify app. Tell me if they are early/late (`LYRIC_LEAD_MS`).
5. Free account or no device: should show "needs Premium" / "open Spotify on a device", not freeze.
6. Send the serial log if a request fails (HTTP codes are not logged yet, add if needed).

### Tilt helper (main.cpp, `tiltBegin()` / `tiltUpdate()`)
On entering Tilt Maze or Fluid it averages 25 MPU samples ("Hold like a phone..." banner) and derives screen-down/right axes from gravity itself, so it works for any MPU mounting. Neutral pose = however a phone is held. Maze uses relative tilt (`tilt.tx/ty`), Fluid uses normalised in-plane gravity (`tilt.gx/gy`, neutral = (0,1)). If the device is held nearly flat it falls back to `TILT_X_SIGN/TILT_Y_SIGN`. Button A in both modes re-zeroes.

### Fluid (fluid.cpp)
Clavet double-density relaxation, all Q8 integer maths (ESP32-C3 has no FPU, avoid floats). Neighbour grid, 3 presets (Water/Honey/Mercury; C cycles). Each preset has a `gscale` (honey 0.35x, mercury 1.25x). Renders a metaball field straight into the U8g2 page buffer. Use `rz()` (round toward zero) for signed shifts, plain `>>` biases and made the surface slope. Tune with `N_PARTICLES` / `SUBSTEPS`; if FPS is low on the C3, lower those first. Host measured about 0.2 ms/frame, C3 cost is UNMEASURED.

### Catch Water (Games menu)
Tilt-controlled glass under a wandering tap, 20 s round, ends with % of drops caught. Same tilt helper/fixed 20 ms step as the maze. A re-zero, A/C again when finished, B back.

### Maze
12x4 cells, fixed 20 ms physics step (was loop-rate dependent), circle-vs-wall-rect collision. B back, A re-zero, C (or A after winning) new maze.

### Other behaviour notes
The touch pad is Pet-mode only (as Home it misfired). Spotify mode: hold B 0.7 s to go back; B short press acts on release. Root menu order: Pet, Fluid, Stats, Motion test, Tools, Games, Online, Settings.

### Settings (MODE_SETTINGS)
Rows (8): Brightness, Screen off, Flip, Menu style, Lyrics sync, Music pet (NVS `musicpet`, default 1), Reset pet (index 6), Back. Brightness (contrast 8/60/150/255), Screen auto-off (Off/30 s/1 min/5 min; wakes on any button/touch/movement and swallows that first press; disabled in Fluid/Maze/Catch), Flip screen (180 deg, `setFlipMode`), Reset pet (B twice), Back. Stored in NVS keys `bright`/`sleep`/`flip`; `applyScreen()` must be called after every `display.begin()`. Tilt calibration is deliberately NOT here: each tilt mode re-zeroes with A.

## Known caveats / things that will bite you
- Keep the pet animation code unchanged unless Salman explicitly asks. Salman has confirmed the existing pet animations look good.
- MPU6050 temperature is the chip's own die temperature: it reads a few degrees above room temperature.
  `TEMP_OFFSET_C` in `config.h` exists to correct it.
- Tilt direction depends on how the MPU is mounted; `TILT_X_SIGN` / `TILT_Y_SIGN` flip it.
- WiFi adds roughly 300-400 KB flash and 40-60 KB RAM once linked. There is plenty of room (about 1 MB free).
- The weather API (Open-Meteo) needs no key but needs HTTPS; the code uses `setInsecure()` (no cert pinning)
  on purpose to keep it small.
- Windows line endings: git may show CRLF noise. Ignore it, do not "fix" files for it.

## Ideas not yet approved
Reaction test, Simon, Dino runner, Breakout, pet reacting to weather, morning greeting, deep sleep.

### Separate Spotify lyrics visualizer (2026-10-11; first implementation, hardware review pending)

**Hard boundary:** the established Spotify animated-lyrics renderer is frozen. This feature adds a separate root-menu mode named **Lyrics visual**. The existing `spotify::draw()` implementation and its layout/animation code were not edited.

**Implementation**
- Added `src/lyrics_visual.h/.cpp`, an independent 128x64 renderer inspired by the reference Reel: one lyric word at a time, a thin outlined word box, and procedural monochrome geometry that rotates between ring, waveform, equalizer-bar, and scribble motifs. During lyric gaps or loading, it shows only a quiet abstract interlude, without song title/artist/status labels.
- Added a read-only `spotify::getLyricsView()` snapshot API in `src/spotify.h/.cpp`. It copies the current synced line, next line, and timing while holding the existing state mutex. It does not draw anything and does not modify the old renderer.
- Added `Lyrics visual` as its own root menu item in `src/main.cpp`. It uses the same Spotify session, Wi-Fi worker, LRCLIB synced lyrics, and playback controls. A/C skip tracks; short B toggles play/pause; hold B returns to the root menu.
- No pin, hardware, pet animation, game, or network implementation changes.

**Files changed**
- `src/lyrics_visual.h` (new)
- `src/lyrics_visual.cpp` (new)
- `src/spotify.h` (read-only snapshot declaration)
- `src/spotify.cpp` (read-only snapshot implementation only; existing renderer left intact)
- `src/main.cpp` (menu, mode lifecycle, input and draw dispatch)
- `HANDOFF.md` (this note)

**Validation:** not yet PlatformIO-built or tested on the device. This was committed to the feature branch `feature/lyrics-visualizer`, not directly to `main`. Please build in PlatformIO, flash, open **Lyrics visual** while Spotify is playing, and check: loading/lyric gaps, short words, long words, rapid word changes, A/C track skip, short B play/pause, and hold B exit. Also visit the original Spotify mode and confirm it remains visually unchanged.

**Rollback:** the feature branch started at `09e46003c05f1fab6c246a077956230148d06b3b` (the pre-feature main commit). To abandon the experiment without touching the stable mode, switch back to `main` or delete `feature/lyrics-visualizer`. The feature branch commits are `efa5168339b9e6f84d191a8a1919083c98d5ee3a`, `5c2c15c26d35bf0b4eec385f44bb5ecd4535bc18`, `917ca88cac4093ae46600b1b157fcb16cc0f79e5`, `244f9b04a900f07ea9aa628e17e6e0fa31dd142c`, `a4fb749123d22b591d32ab683e88e65f78d495e2`, and `fdfe2a42b0315bd2248612de67113339397f5b30`.

### Quick connect (2026-10-11; not yet hardware-validated)
- online.cpp: the last good network, channel and BSSID are kept in RAM. The next session tries exactly that first (`WiFi.begin(ssid, pass, channel, bssid)`, 4 s timeout, no scan) and falls back to the scan if it fails. Settle delay 600 -> 200 ms.
- spotify.cpp: the access token is kept in RAM when leaving Spotify (valid ~1 h), so re-entering skips the login request; the pause before the first request is 150 ms instead of 700 ms.
- Rollback: revert this commit.

### Lyrics visual: reel-style scenes (2026-10-11; not yet hardware-validated)
- `src/lyrics_visual.cpp` only. Each new word picks one of 8 scenes (never the same twice in a row), modelled on a reel Salman showed: crossing sine waves, falling dashed rain, synthwave sun + grid, radar arcs with equalizer, swirling vortex, spinning polygons / scribble web, calm flickering ticks, and an inverted "BLUE" glitch screen with cracks and an XOR band. The word sits in a framed box that drops in on change, with a short glitch flash. With no lyrics yet it shows a slow synthwave horizon.
- Word selection, Spotify data, controls and the old Spotify screen are untouched.
- U8g2 coordinates are unsigned 8-bit, so every scene line goes through `ln()`, which clips to the screen first. Do not call `drawLine` directly with off-screen points.
- Rollback: revert this commit.

### Wi-Fi speed fix + visualizer status pill (2026-10-11; not yet hardware-validated)
- Salman reported the connection got slower after the quick-connect change. Likely cause: the remembered channel/BSSID was pinned in `WiFi.begin`; phone hotspots and mesh routers change those, so the pinned attempt failed and cost seconds before the normal path. Now only the last network is remembered (plain `WiFi.begin`, own scan skipped, 5 s timeout, then the normal scan). Cause is NOT confirmed on hardware.
- Serial timing log added: `wifi: +ms attempt ...`, `wifi: connected +ms`, and one `net: host/path -> code in N ms, heap N KB` line per Spotify/LRCLIB request. If it is still slow, read the serial monitor to see which step takes the time.
- The visualizer counts as the drawn frame for the request gate (it used to wait the 250 ms gate timeout after every request).
- Lyrics visual now shows a small status pill over the interlude: connecting wifi / logging in / asking spotify / finding lyrics / nothing playing / no synced lyrics / error text (`LyricsView::status`, `statusBusy`).

### Shared connection, timestamp sync, lyrics-sync setting (2026-10-12; not yet hardware-validated)
- **One connection for everything.** Spotify and Lyrics visual already used the same session code, but leaving a mode switched the radio off and cleared the track. Now `online.cpp` keeps Wi-Fi up for 45 s after the last user leaves (`LINGER_MS`), `online::enter()` reuses a live connection, and `spotify::enter()` does a "warm return" (keeps track, lyrics and token, polls immediately) when you come back within 45 s. Switching Spotify <-> Lyrics visual (or into Online and back) is now near-instant. After 45 s the radio goes off to save battery.
- **Sync.** The poll now reads Spotify's `timestamp` and, when NTP has set the clock, adds `now - timestamp` to `progress_ms` (log line `sync: timestamp method, corr N ms`). If the clock is not valid it falls back to the RTT/2 correction GPT added (`syncBiasMs`). This also affects the normal Spotify screen's position (more accurate, animations unchanged).
- **Settings > Lyrics sync** (-500..+800 ms, saved in NVS `lyoff`): + shows lyrics earlier, - later. Applies to both Spotify and Lyrics visual. Use it for Bluetooth speaker latency.
- Lyric request heap check now runs after the old TLS connection is closed (it used to fail with -2 while the api.spotify.com connection was still holding its buffers); minimum 45 KB; the visualizer shows `lyrics failed (-2)` etc. instead of "no synced lyrics" when the cause is not a 404.

### Lyrics failed (-1) diagnostics (2026-10-12)
- Salman: Lyrics visual ran ~2 min then showed `lyrics failed (-1)` (HTTPClient connection error to lrclib.net). New: DNS is resolved first (`net: dns host ok/FAILED in N ms`, code -6 on failure), connection errors log mbedtls `lastError`, free heap and the largest free block, and the lyric retry delay is 2.5 s instead of 5 s. Next step depends on those serial lines: DNS failure = network/ISP resolver; TLS error with a small largest block = memory; timeout = lrclib unreachable from that network.

### Urdu / Arabic lyrics and music notes (2026-10-13; not yet hardware-validated)
- Lyrics in Arabic script (Urdu, Arabic, Persian) are now drawn instead of `?`. `src/arabic_shape.{h,cpp}` picks the isolated/initial/medial/final letter forms (table generated by `tools/gen_arabic_table.py` into `src/arabic_forms.inc` from Python's Unicode data), makes lam+alef ligatures, drops vowel marks, reverses to visual order and lays words out in rows of up to 15 glyphs. Drawing uses `u8g2_font_unifont_t_urdu` glyph by glyph (`drawGlyph`).
- Pool storage: a lyric line that contains Arabic script is stored as raw UTF-8 with a leading 0x1B marker; every other line is converted to Latin-1 at parse time as before. `LyricsView::line/nextLine` carry the marker too (buffers 128 bytes; pool 12000 bytes).
- Spotify screen: Urdu lines use `drawBigRtl()` (2 rows, inverted focus word, first word rightmost). Lyrics visual: one shaped word per box. Song title / artist in the header are still Latin-1 only, so Urdu titles show `?` there.
- Music notes (U+2669..266C) are dropped by `toLatin1`, so a line with only a note becomes an instrumental gap (bouncing dots).
- Collision note: another agent had uncommitted work on this feature in the same working folder. `arabic_shape.*` and `arabic_forms.inc` were rewritten (API kept: `hasArabic`, `shapeWord`, `layoutRows`, `rowWidth`, `drawGlyphs`, `MAX_COLS`). Only one agent should edit the repo at a time.

### Lyrics visual overhaul (2026-10-13; PC-previewed only, not yet hardware-validated)
`src/lyrics_visual.cpp` was rebuilt around a per-word "look" rolled from a hash of the word key (`Look` struct in `draw()`), so every word differs but the same word always looks the same:
- **16 scenes** (8 old + starfield, tunnel, ripples, checker, sunburst, DNA, spectrum, orbits); never the same scene twice in a row. `gKick` (decays 220 ms after each word) makes the spectrum bars pulse.
- **Box entry**: CRT grow, drop+bounce, slide, card flip (inverted back face), zoom kick, shake (240 ms, `ENTRY_MS`).
- **Box decoration**: plain, marching ants, breathing brackets, drop shadow, rounded frame + orbiting dot, ruler ticks + chevrons.
- **Colour flipping**: inverted box, strobe then periodic pulse, scan bar XOR through the box, negative scene (permanent or flickering every 520 ms), whole-screen flash on 1 in 5 words.
- **Letter effects** (Latin text only): pop-in, wave, jitter; short words may use `logisoso16`. Urdu words keep whole-word entry only.
- **Transitions** (190 ms, `TRANS_MS`): blinds, shutter, curtains, scanline dissolve. Bottom bar shows word position in the line.
- All off-screen-capable drawing goes through the clipped helpers `px/hl/vl/bx/fr/ln` (U8g2 coordinates are unsigned 8-bit).
- To tune: probabilities are in `draw()` (`flip`, `neg`, `fx`, `big`, `flash`); timings are the two constants at the top. Check on device: frame rate with the heavier scenes (tunnel/ripples/checker), strobe comfort, and whether the progress bar is wanted.

### Word timing inside a lyric line (2026-10-14; host-tested, not yet hardware-validated)
LRC only has line start times, so which word is "being sung" used to be guessed from character count (long/held words were wrong). Now:
- `src/lyric_timing.{h,cpp}` (new): `estimate()` gives word start times from syllable counts (`syllables()`, silent final e handled; Urdu/Arabic ~2 letters per syllable). Short lines: words at syllable pace stretched by 40% of the spare time, the LAST word is held until the line ends. Slow lines (words fill >=60% of the line): all words stretched over the line, last word weighted x1.4. `focusIndex()` picks the word.
- `parseLrc()` also reads **Enhanced LRC** word tags (`<mm:ss.xx>word`) when LRCLIB has them: real per-word times are stored in `wordT[]` (`Lyric.wt/nw`) and used instead of the estimate when at least half the words are tagged and the cleaned text still has the same words.
- `spotify::wordFocus(line, relMs, span)` is the single source of truth. The Spotify screen (`drawBig`/`drawBigRtl` take a word index now, not a 0..1000 fraction) and the visualizer (`LyricsView::focusWord`) both use it, so they agree.
- Tune: constants in `lyric_timing.cpp` (`200 ms/syllable + 60`, 40% stretch, 1.4x last word, 60% slow-line threshold). Global early/late is still Settings > Lyrics sync. Check on device with a long-held-note song, and note `lyric_timing` was started by the other agent (uncommitted at the time) and finished here.

### Battery resets in Online mode (2026-11-09)
Salman: on battery power only, entering Online mode reboots the device (fine on USB). Likely brownout from the Wi-Fi radio's current peaks (TX power is already 8.5 dBm). Stats now shows `boot: <reason>` (esp_reset_reason) and the boot log has it too: `BROWNOUT` confirms it. Fixes are hardware: a 470-1000 uF capacitor across 3V3/GND near the ESP, a charged battery with enough current capability, short thick wires, battery into the 5V/VIN pin via the TP4056 OUT (never straight into 3V3).

### Visualizer breaks, adaptive tempo, faster Wi-Fi (2026-11-09; host-checked only)
- **Breaks no longer drop to the synthwave screen.** `LyricsView::inGap` (+`gapStartMs/gapEndMs`) is true for an intro or a blank LRC line. `lyrics_visual::draw()` then lets the last word linger 1.2 s (held note fading out) and shows a box with three bouncing dots (`drawBreak`) over the SAME scene. The synthwave ambient screen is now only for no track / loading / no synced lyrics.
- **Adaptive tempo.** Scenes and decorations run on `vclock`, a visual clock advanced by `advanceClock()` at a smoothed speed factor: line pace in syllables/s divided by 3.5 (clamped 0.55..1.9), 0.7 during breaks, 0.3 when paused. Box entry/transition animations stay on real time. Spotify's audio-features (BPM) endpoint is not available to new apps, so lyric pace is the proxy.
- **Wi-Fi.** `online.cpp`: modem sleep is switched off while a mode uses the connection (`updatePs`, big latency win for TLS round trips) and back on during the 45 s linger; `WIFI_LOW_LATENCY 0` in secrets.h disables that (battery). `WiFi.persistent(false)`; scan now 110 ms/channel (was 300). Not done on purpose: static-IP/DHCP caching (breaks on hotspots), BSSID pinning (tried before, slower).

### New home screen + launcher + background levelling (2026-11-10; PC-previewed and host-checked, NOT yet on the device)
- **Flow:** boot -> `MODE_PET` (home/idle). B on the pet -> `MODE_MENU` = launcher. In the launcher: short B (on release) opens the app, hold B 0.7 s or 20 s without input -> back to the pet. Apps still return to the launcher (`enterMode(MODE_MENU)`), which reselects `menuIndex - 1`. `menuIndex` keeps the old rootItems numbering (0 = Pet, 1..10 = apps) so all the existing "hold B returns to menu item N" code still works.
- **Styles:** `setMenu` (NVS "menu", Settings row "Menu style"): 0 carousel (A/C, icons glide in from the right, brackets around the middle icon, label rises from below, dot row), 1 tilt ring (10 icons on an ellipse; tilt direction picks the nearest item with hysteresis; the highlighted one is inverted on a white disc; icons fly out of the middle on entry). Constants: ring `RING_RX/RY`, carousel `STEP`, tilt deadzone 0.13 in `launcher::input`.
- **Background calibration** (`motionBackground()` in main.cpp, every mode): gyro bias from the first 50 calm samples (subtracted in `mpuRead`); `lvl` keeps a calm-gravity average; the first pose after boot is applied after 0.5 s calm via `tiltApplyPose()` (split out of `tiltBegin`); in Pet mode the pose is re-applied after `LEVEL_HOLD` (1.5 s) of stillness in a pose >~10 deg away; `levelForLauncher()` re-bases tilt on the pose just before the B press. The pet's eyes now follow `tilt.tx/ty` (calibrated) instead of the raw accelerometer axes. Games still do their own `tiltBegin()`.
- Verify on the device: tilt directions (if left/right or up/down feel mirrored the axis derivation in `tiltApplyPose` is the place), ring crowding at the left/right sides, 20 s auto-return, and that the pet's gaze feels right after the first-boot calibration.

### Games and menu revamp (2026-11-12; host-checked, PC-rendered, fuzzed; NOT flashed yet)
**Menus.** `launcher::enterSub(items, count, selected, style, now, valueFn)` shows any list in the home-screen style. Tools, Games and Settings use it from main.cpp (`openSubMenu`, `menuPick` = the shared B logic: short B on release opens, hold 0.7 s goes up a level, 20 s idle returns to the pet); the Online list uses it from online.cpp (pill = Wi-Fi status). Every sub-menu ends with a Back item. `Settings` shows its value in the pill (`settingsValue`), Games shows `best N` (`gamesValue`). Menu style toggled in Settings restyles immediately (`launcher::restyle`).
**Games** (`games.cpp`, fixed 20 ms step, every game restarts with A/C after game over and asks main.cpp for a tilt re-zero via `FLAG_REZERO`):
- Star Blaster: tilt = ship position (absolute), A rapid fire, C smart bomb (1 to start, +1 every 15 kills, max 3), pickups: weapon (3 levels), life, bomb.
- Sniper: tilt = scope speed (rate control, dead zone 0.05), A fires, bolt 0.9 s, C hold = 2x zoom + steady (3 s of breath, then a gasp). Targets live `2.8 - 0.06*kills` s (min 1.1), a missed one costs a life. Headshot 3, body 1. Blips on the scope ring point at targets that are out of view.
- Road Rush: 35 s, checkpoint every 1000 m then every 1200 m (+20 s), cars cost 2 s and speed. `CK` (curve strength) and `HWP` (road width) at the top of `road::` are the look knobs.
- Pinball: table on its side, gravity +x 220 px/s^2, 4 physics substeps per 20 ms, flippers are capsules with angular-velocity transfer, 3 bumpers (50 x combo points), 3 balls. Shake = nudge (3 nudges in a short time = TILT, flippers off until the ball drains).
- Snake: now steers by tilt (|tilt| > 0.22) as well as A/C, and cannot U-turn into its neck. Tilt Maze unchanged. 8-ball and Dice moved to Tools and react to a shake.
- Best scores: NVS keys `bestStar/bestSnip/bestRoad/bestPin`, written once when a new best is set.
**PC tooling.** `tools/gamepreview/build.sh` then `/tmp/pocketpet-preview/preview OUTDIR` writes frame dumps (`python3 tools/fluidtest/render.py OUTDIR/x.bin x.png 3` makes a contact sheet) and prints the AI-player results; `preview OUTDIR fuzz` is the random-input torture test (build it with `-fsanitize=address,undefined`, see the command in the commit message of this change). It includes `games.cpp` directly, so tests can read game internals.
**Check on the device.** (1) every menu in both styles, Back items, hold B; (2) each game: tilt direction feels right (if a game steers the wrong way the tilt helper's axes are the place), frame rate (Road Rush and Sniper redraw the most), difficulty; (3) Pinball: do the flippers feel strong enough, does shake-nudge trigger too easily (`0.55 g` threshold in `pin::step`); (4) Snake tilt dead zone; (5) Online list pill text while connecting.

### Review fixes 2026-11-14 (host-checked only, not flashed)
Salman asked for a repo review and for "all the small quick stuff first". Done:
- **Stats > System page** (`drawStats()` in main.cpp, `statsPage`, `dbgFps/dbgLoopHz`): on the Stats screen A or C flips between the pet bars and a system page (FPS, loop rate, free heap, min heap, largest free block, app size, uptime, reset reason). The serial status line also prints `fps= heapK= minK= blockK=`. This answers the "C3 cost unmeasured" and heap questions above: ask Salman for a screenshot / serial lines after using Online, Spotify and Lyrics visual.
- **CI:** `.github/workflows/build.yml` runs `pio run` (with `secrets.example.h` copied to `secrets.h`) and `tools/hostcheck/check.sh` on every push, prints RAM/flash in the run summary and keeps `firmware.bin` as an artifact. If the workflow file did not make it to GitHub (the push token may lack the `workflow` scope), copy it in by hand.
- **Docs:** button pins now match `config.h` (A=GPIO2, C=GPIO0; the docs said the opposite), stale "PAUSED" banner updated, dead `pcb/README.md` references explained, literal `\n` in the README checklist fixed, memory numbers refreshed.
- **Open for Salman:** confirm A=2 / C=0 on the real board (pet tickle = A should be the button that was wired to GPIO2). Ideas he was shown, none approved yet: night sleep for the pet (`online::petHint()` has `is_day`), battery gauge on GPIO3 (2x100k divider), light/deep sleep with wake on GPIO 0-5, pet reacts to Spotify, gesture tricks, OTA with two ~1.69 MB slots, safe mode (hold B at boot), Wi-Fi setup portal, validating TLS certificates for the Spotify host instead of `setInsecure()`.

### Music pet (2026-11-14; host-tested and PC-rendered only, NOT flashed)
Salman asked for the pet to react to music with different reactions per genre.
- **Flow:** Pet mode + Settings > Music pet On + screen on -> `spotify::enter()` as a background session (loop() block `musicBg` in main.cpp; leaves on screen-off / other mode). `spotify::getMusic()` returns `vibe::Music` (vibe, guessed, energy, beatMs, positionMs, singing, word, trackSeq). `petmusic::pose/decor` apply it in drawPet. Screen auto-off is suppressed while music plays in Pet mode.
- **Genre source:** `GET /v1/artists/{id}` (`NW_GENRE` job) -> `vibe::fromGenres`. Spotify's Feb 2026 changelog removed popularity/followers; genres were not listed as removed, but NOT confirmed live. If the call fails, `vibe::guess` uses title words, Urdu/Hindi script and lyric speed, and the label shows `name?`. Serial logs: `genre: [...] -> vibe`, `lyrics: pace ...`. **Ask Salman for those lines.**
- **Tempo:** no audio analysis exists, so `bpmFor(vibe, pace)` gives a feel-tempo (60-170) locked to song position. It looks in time but is not the real beat.
- **Cost:** keeps Wi-Fi up (45 s linger in online.cpp) while Pet mode plays music; Settings > Music pet Off disables it.
- **Check on the device:** genre accuracy for his playlists, whether each vibe looks right on the real OLED (chill cups, EDM strobe), battery drain, no stutter from the extra request.
