Salmon10k/Pocketpet.esp32c3/Simulations/fluid 2.webp

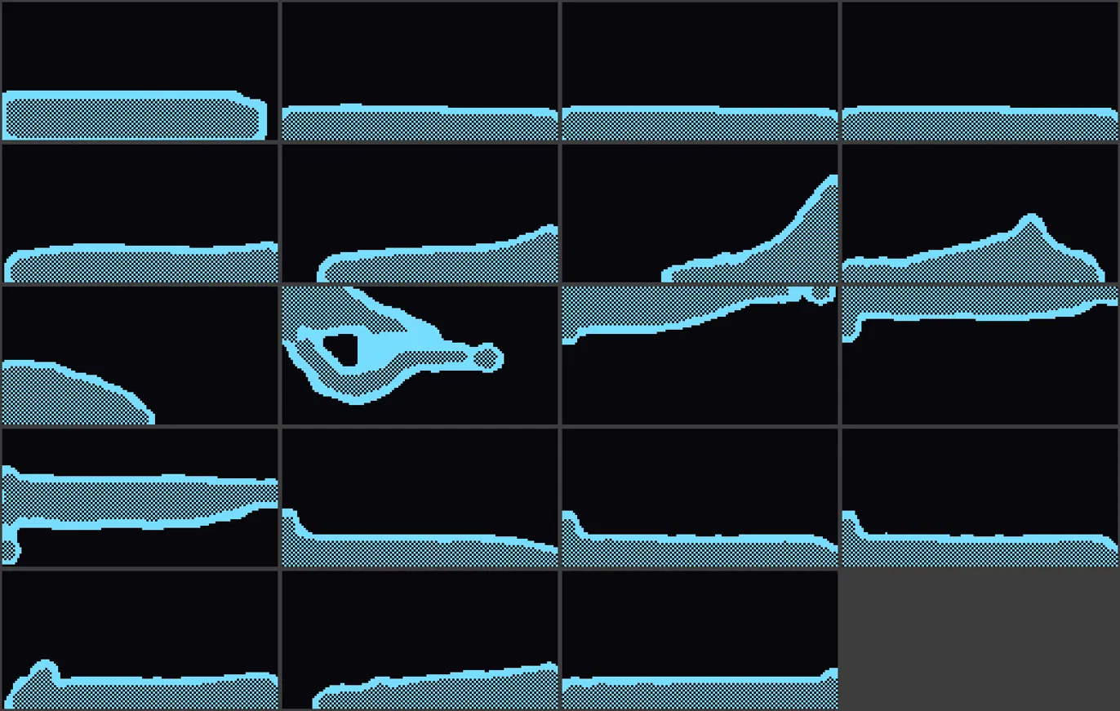
Simulations/fluid 2.webp
