Salmon10k/Pocketpet.esp32c3/PCB/PCB.kicad_pcb

## KiCad design PCB/PCB.kicad_pcb (2026-11-13)

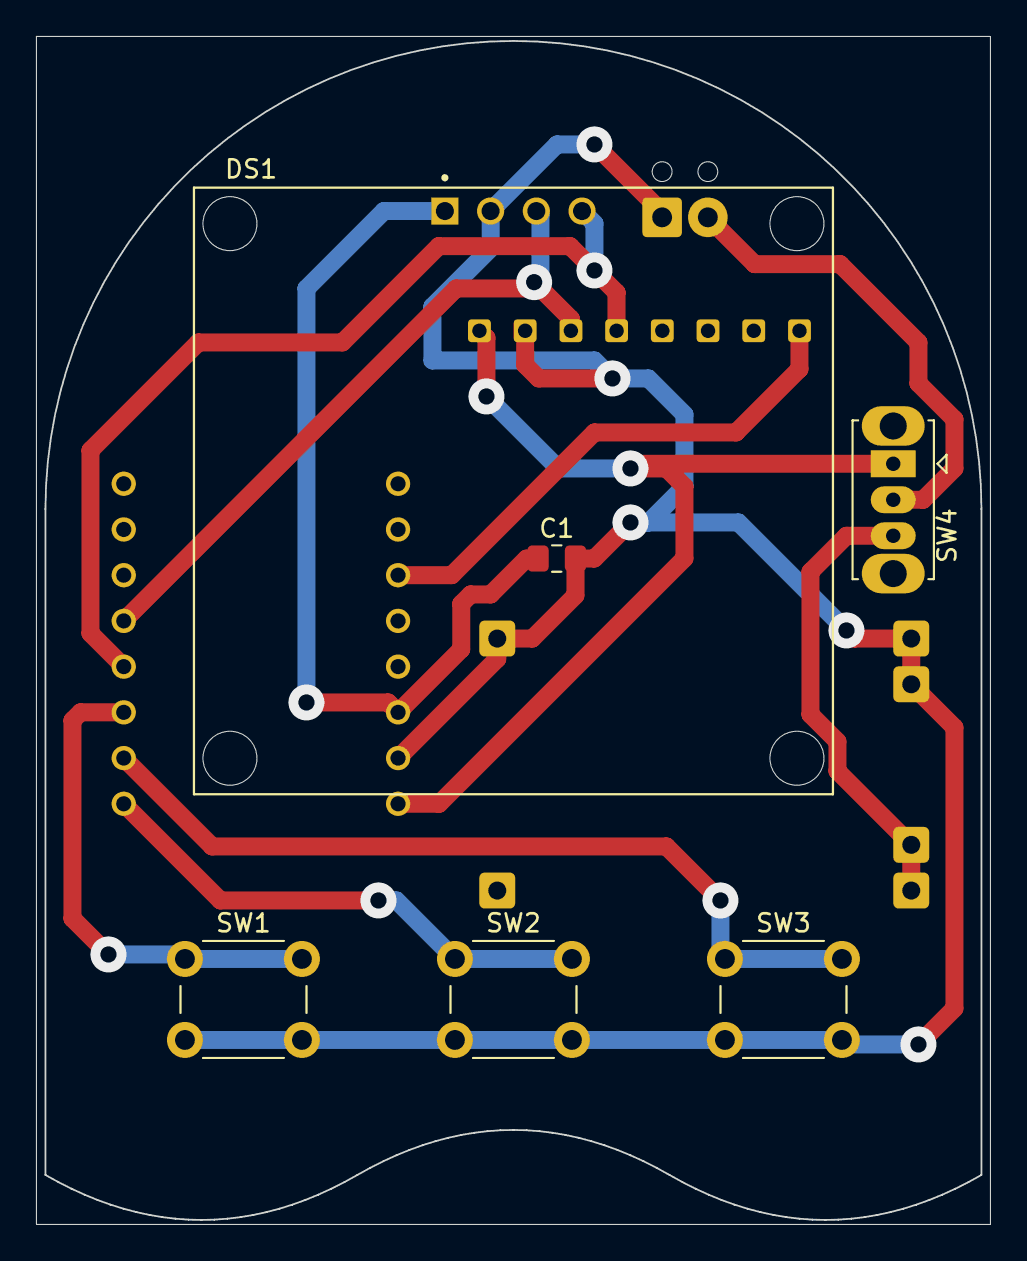
[picture p4: board PCB.kicad_pcb from above]

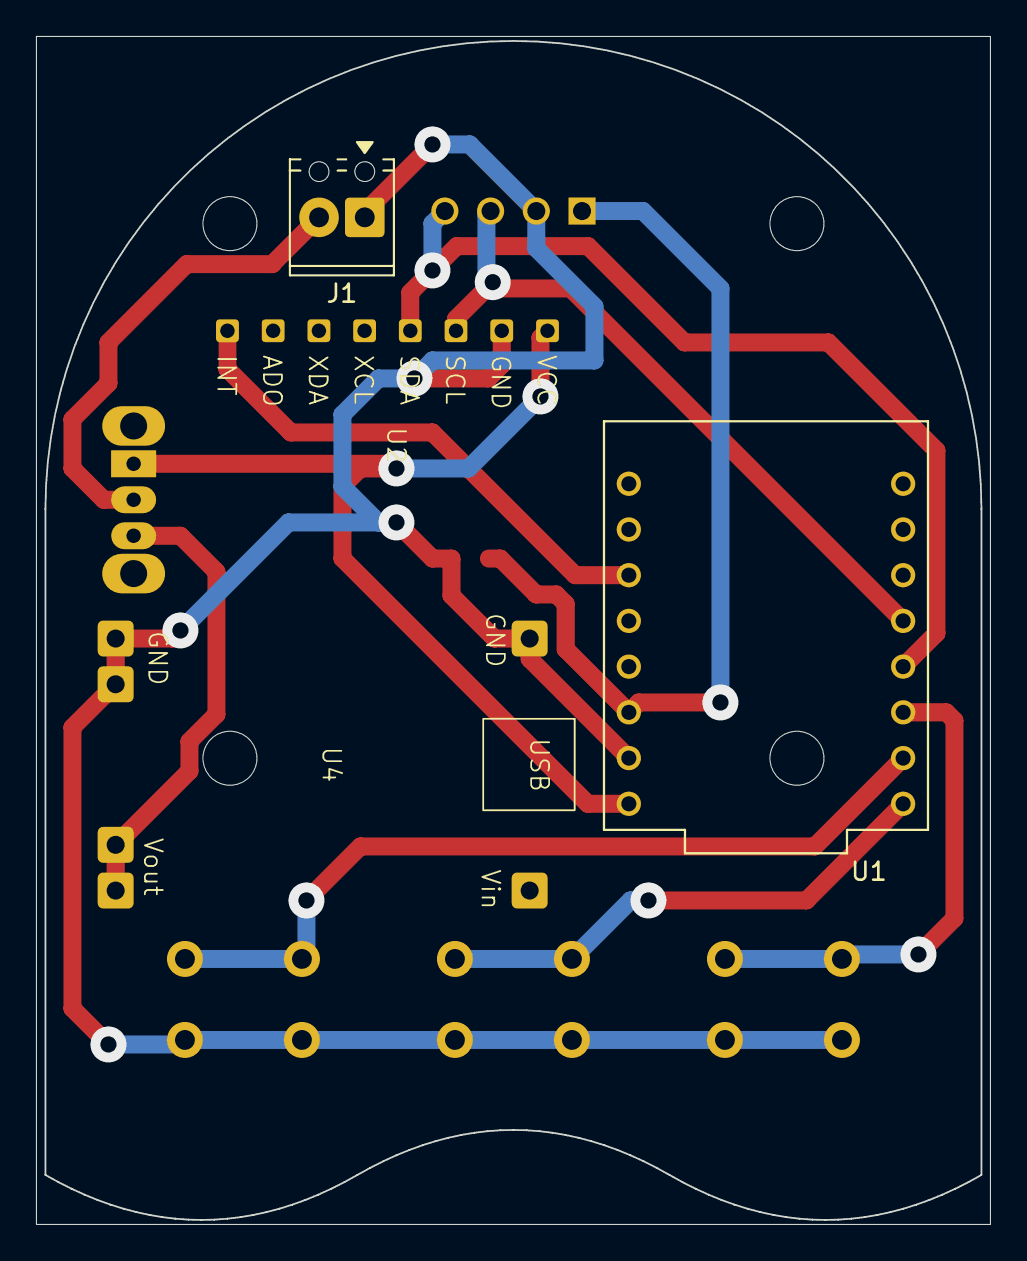
[picture p5: board PCB.kicad_pcb from below]

Board: 2 copper layers, 53.0 x 66.0 mm, 10 parts (4 on the bottom side), 11 nets.

Parts:
C1: C; C_0805_2012Metric_Pad1.18x1.45mm_HandSolder
DS1: OLED_128X64_1.3_I2C; LCD_OLED_128X64_1.3_I2C
J1: Battery; TerminalBlock_Phoenix_MPT-0,5-2-2.54_1x02_P2.54mm_Horizontal
SW1, SW2, SW3: SW_Push; SW_PUSH_6mm
SW4: SW_SPDT; SW_Slide_SPDT_Straight_CK_OS102011MS2Q
U1: ESP32-C3_SUPERMINI_TH; MODULE_ESP32-C3_SUPERMINI_TH
U2: MPU6050
U4: TP4056

Connections:
+3V3: C1.1, DS1.1 (VDD), U1.3.3 (3V3)
+BATT: J1.2, SW4.2 (B)
G2: U1.2 (GPIO2), U2.8 (INT)
G5: SW2.1, U1.5 (GPIO5)
G6: SW3.1, U1.6 (GPIO6)
G7: SW1.1, U1.7 (GPIO7)
G8: DS1.4 (SDA), U1.8 (GPIO8), U2.4 (SDA)
G9: DS1.3 (SCK), U1.9 (GPIO9), U2.3 (SCL)
GND: C1.2, DS1.2 (GND), J1.1, SW1.2, SW2.2, SW3.2, U1.G (GND), U2.2 (GND), U4.2 (GND)
VCC: SW4.1 (A), U1.5V, U2.1 (VCC)
Vch: SW4.3 (C), U4.3 (Vout)
