Salmon10k/Pocketpet.esp32c3/src/spotify.cpp

#include "spotify.h"
#include "online.h"
#include "arabic_shape.h"
#include "lyric_timing.h"
#include "vibe.h"
#include "config.h"
#include <WiFi.h>
#include <WiFiClientSecure.h>
#include <HTTPClient.h>
#include <ArduinoJson.h>
#include <Preferences.h>
#include <string.h>
#include <sys/time.h>
#include <freertos/FreeRTOS.h>
#include <freertos/task.h>
#include <freertos/semphr.h>
#if __has_include("secrets.h")
#include "secrets.h"
#endif

#ifndef SPOTIFY_CLIENT_ID
#define SPOTIFY_CLIENT_ID ""
#endif
#ifndef SPOTIFY_REFRESH_TOKEN
#define SPOTIFY_REFRESH_TOKEN ""
#endif

namespace spotify {
namespace {

// ---------------------------------------------------------------- tuning
const uint32_t POLL_PLAYING_MS = 4000;     // how often to ask Spotify what is playing
const uint32_t POLL_PAUSED_MS  = 8000;
const uint32_t HTTP_TIMEOUT_MS = 8000;
const int      LYRIC_LEAD_MS   = 300;      // show a line slightly early (network + draw delay)
const int      MAX_LINES       = 160;
const int      POOL_BYTES      = 12000;
const int      MAX_BODY        = 24000;    // refuse lyric answers bigger than this
const uint32_t MIN_HEAP        = 45000;    // a TLS handshake needs roughly this much free heap

const bool configured = SPOTIFY_CLIENT_ID[0] && SPOTIFY_REFRESH_TOKEN[0];

// ---------------------------------------------------------------- pure helpers (host-tested)
// ---- helpers begin
// U8g2 *_tf fonts want one byte per character (Latin-1), not UTF-8. Convert in place.
// Curly quotes and dashes become ASCII, anything outside Latin-1 becomes one '?'.
void toLatin1(char *s) {
  char *w = s;
  bool lastQ = false;
  for (const unsigned char *r = (const unsigned char *)s; *r;) {
    uint32_t cp;
    if (*r < 0x80) { cp = *r++; }
    else if ((*r & 0xE0) == 0xC0 && (r[1] & 0xC0) == 0x80) { cp = ((r[0] & 0x1F) << 6) | (r[1] & 0x3F); r += 2; }
    else if ((*r & 0xF0) == 0xE0 && (r[1] & 0xC0) == 0x80 && (r[2] & 0xC0) == 0x80) {
      cp = ((r[0] & 0x0F) << 12) | ((r[1] & 0x3F) << 6) | (r[2] & 0x3F); r += 3;
    } else if ((*r & 0xF8) == 0xF0 && (r[1] & 0xC0) == 0x80 && (r[2] & 0xC0) == 0x80 && (r[3] & 0xC0) == 0x80) {
      cp = 0x10000; r += 4;
    } else { cp = '?'; r++; }
    if (cp == 0x2018 || cp == 0x2019) cp = '\'';
    else if (cp == 0x201C || cp == 0x201D) cp = '"';
    else if (cp == 0x2013 || cp == 0x2014) cp = '-';
    else if (cp == 0x2026) { *w++ = '.'; *w++ = '.'; cp = '.'; }
    else if (cp == 0x00A0) cp = ' ';
    else if (cp >= 0x2669 && cp <= 0x266C) continue;                       // music notes (the font has none): drop them
    if (cp > 0xFF) { if (lastQ) continue; cp = '?'; }
    lastQ = (cp == '?');
    *w++ = (char)cp;
  }
  *w = 0;
}

// Percent-encode UTF-8 for a query string. Returns false when out is too small.
bool urlEncode(const char *s, char *out, size_t cap) {
  static const char HEXD[] = "0123456789ABCDEF";
  size_t n = 0;
  for (const unsigned char *p = (const unsigned char *)s; *p; p++) {
    bool safe = (*p >= 'a' && *p <= 'z') || (*p >= 'A' && *p <= 'Z') || (*p >= '0' && *p <= '9') ||
                *p == '-' || *p == '_' || *p == '.' || *p == '~';
    if (n + (safe ? 1 : 3) + 1 > cap) { if (cap) out[0] = 0; return false; }
    if (safe) out[n++] = (char)*p;
    else { out[n++] = '%'; out[n++] = HEXD[*p >> 4]; out[n++] = HEXD[*p & 15]; }
  }
  out[n] = 0;
  return true;
}

// "Song - 2011 Remastered (feat. X) [Live]" -> "Song". Used for the second lyrics lookup.
void cleanTitle(const char *src, char *dst, size_t cap) {
  size_t n = 0;
  int depth = 0;
  for (const char *p = src; *p && n + 1 < cap; p++) {
    if (p[0] == ' ' && p[1] == '-' && p[2] == ' ') break;
    if (*p == '(' || *p == '[') { depth++; continue; }
    if ((*p == ')' || *p == ']') && depth > 0) { depth--; continue; }
    if (depth == 0) dst[n++] = *p;
  }
  while (n > 0 && dst[n - 1] == ' ') n--;
  dst[n] = 0;
  if (n == 0) { strncpy(dst, src, cap - 1); dst[cap - 1] = 0; }
}

// wt/nw: optional real per-word start times (Enhanced LRC "<mm:ss.xx>word"), ms from the line start, in wordT[]
struct Lyric { uint32_t ms; uint16_t off; uint16_t wt; uint8_t nw; };
const int WORDT_CAP = 640;
Lyric lines[MAX_LINES];
int lineCount = 0;
char pool[POOL_BYTES];
int poolUsed = 0;
uint16_t wordT[WORDT_CAP];
int wordUsed = 0;

// "<mm:ss.xx>" at c (c < end). On success returns true, sets ms and next (just after '>').
bool parseWordTag(const char *c, const char *end, uint32_t &ms, const char *&next) {
  if (c >= end || *c != '<') return false;
  const char *t = c + 1;
  if (!(*t >= '0' && *t <= '9')) return false;
  uint32_t mm = 0, ss = 0, frac = 0;
  while (t < end && *t >= '0' && *t <= '9') mm = mm * 10 + (uint32_t)(*t++ - '0');
  if (t >= end || *t != ':') return false;
  t++;
  if (!(t < end && *t >= '0' && *t <= '9')) return false;
  while (t < end && *t >= '0' && *t <= '9') ss = ss * 10 + (uint32_t)(*t++ - '0');
  if (t < end && (*t == '.' || *t == ':')) {
    t++;
    int digits = 0;
    while (t < end && *t >= '0' && *t <= '9') {
      if (digits < 3) { frac = frac * 10 + (uint32_t)(*t - '0'); digits++; }
      t++;
    }
    while (digits < 3) { frac *= 10; digits++; }
  }
  if (t >= end || *t != '>') return false;
  ms = mm * 60000UL + ss * 1000UL + frac;
  next = t + 1;
  return true;
}

// space-separated words: start/end offsets of each, up to cap. Returns the count.
int tokenize(const char *s, int *ts, int *te, int cap) {
  int n = 0;
  const char *p = s;
  while (*p && n < cap) {
    while (*p == ' ') ++p;
    if (!*p) break;
    ts[n] = (int)(p - s);
    while (*p && *p != ' ') ++p;
    te[n++] = (int)(p - s);
  }
  return n;
}

// Index of the word being sung `relMs` after line `li` started (-1 if there is no such line). Uses the real word
// times of an Enhanced LRC line when it has them, otherwise lyric_timing::estimate() (syllable pace, last word held).
int wordFocus(int li, int32_t relMs, uint32_t spanMs) {
  if (li < 0 || li >= lineCount) return -1;
  uint32_t starts[lyric_timing::MAX_WORDS];
  int n;
  if (lines[li].nw > 0) {
    n = lines[li].nw;
    for (int i = 0; i < n; i++) starts[i] = wordT[lines[li].wt + i];
  } else {
    n = lyric_timing::estimate(pool + lines[li].off, spanMs, starts, lyric_timing::MAX_WORDS);
  }
  return lyric_timing::focusIndex(starts, n, relMs < 0 ? 0U : (uint32_t)relMs);
}

// Parse "[mm:ss.xx]text" lines (several leading timestamps allowed). Lines are sorted by time.
// Metadata tags like [ar:Artist] are skipped. Returns the number of lines kept.
int parseLrc(const char *lrc) {
  lineCount = 0;
  poolUsed = 0;
  wordUsed = 0;
  const char *p = lrc;
  while (*p && lineCount < MAX_LINES) {
    const char *eol = p;
    while (*eol && *eol != '\n') eol++;
    uint32_t times[4];
    int nt = 0;
    const char *q = p;
    while (*q == '[' && nt < 4) {
      const char *t = q + 1;
      if (!(*t >= '0' && *t <= '9')) break;
      uint32_t mm = 0;
      while (*t >= '0' && *t <= '9') mm = mm * 10 + (uint32_t)(*t++ - '0');
      if (*t != ':') break;
      t++;
      if (!(*t >= '0' && *t <= '9')) break;
      uint32_t ss = 0;
      while (*t >= '0' && *t <= '9') ss = ss * 10 + (uint32_t)(*t++ - '0');
      uint32_t frac = 0;
      if (*t == '.' || *t == ':') {
        t++;
        int digits = 0;
        while (*t >= '0' && *t <= '9') {
          if (digits < 3) { frac = frac * 10 + (uint32_t)(*t - '0'); digits++; }
          t++;
        }
        while (digits < 3) { frac *= 10; digits++; }
      }
      if (*t != ']') break;
      times[nt++] = mm * 60000UL + ss * 1000UL + frac;
      q = t + 1;
    }
    if (nt > 0) {
      while (q < eol && *q == ' ') q++;
      const char *e = eol;
      while (e > q && (e[-1] == ' ' || e[-1] == '\r')) e--;
      char tmp[128];                                    // the line without its timestamps and word tags
      int tl = 0;
      uint32_t tagMs[lyric_timing::MAX_WORDS * 2];
      int tagPos[lyric_timing::MAX_WORDS * 2], ntag = 0;
      const char *c = q;
      while (c < e && tl < 120) {
        uint32_t wms; const char *nx;
        if (*c == '<' && parseWordTag(c, e, wms, nx)) {   // Enhanced LRC word tag: remember when it sits in the text
          if (ntag < lyric_timing::MAX_WORDS * 2) { tagMs[ntag] = wms; tagPos[ntag] = tl; ntag++; }
          c = nx;
          continue;
        }
        tmp[tl++] = *c++;
      }
      while (c < e && tl > 0 && (((unsigned char)*c) & 0xC0) == 0x80) { tl--; c--; }   // never cut inside a UTF-8 character
      tmp[tl] = 0;
      int rawTs[lyric_timing::MAX_WORDS], rawTe[lyric_timing::MAX_WORDS];
      int rawTokens = ntag ? tokenize(tmp, rawTs, rawTe, lyric_timing::MAX_WORDS) : 0;
      uint32_t tokT[lyric_timing::MAX_WORDS];
      for (int i = 0; i < rawTokens; i++) tokT[i] = 0xFFFFFFFFUL;
      for (int k = 0; k < ntag; k++) {                  // a tag belongs to the word it sits in or just before
        for (int i = 0; i < rawTokens; i++) {
          if (tagPos[k] < rawTe[i]) { if (tokT[i] == 0xFFFFFFFFUL) tokT[i] = tagMs[k]; break; }
        }
      }
      bool rtl = arabic::hasArabic(tmp);               // Urdu / Arabic: keep the UTF-8, marked with 0x1B, and shape it when drawing
      if (!rtl) { toLatin1(tmp); int a = 0, b = (int)strlen(tmp); while (tmp[a] == ' ') a++; while (b > a && tmp[b - 1] == ' ') b--; memmove(tmp, tmp + a, (size_t)(b - a)); tmp[b - a] = 0; if (b - a > 90) tmp[90] = 0; }
      // real word times are only used when the cleaned text still has the same words and at least half of them are tagged
      uint16_t wtOff = 0; uint8_t nw = 0;
      if (rawTokens > 0) {
        int fts[lyric_timing::MAX_WORDS], fte[lyric_timing::MAX_WORDS];
        int finalTokens = tokenize(tmp, fts, fte, lyric_timing::MAX_WORDS);
        int known = 0;
        for (int i = 0; i < rawTokens; i++) if (tokT[i] != 0xFFFFFFFFUL) known++;
        if (finalTokens == rawTokens && known * 2 >= rawTokens && wordUsed + rawTokens <= WORDT_CAP) {
          uint32_t rel[lyric_timing::MAX_WORDS];
          for (int i = 0; i < rawTokens; i++) rel[i] = tokT[i] == 0xFFFFFFFFUL ? 0xFFFFFFFFUL : (tokT[i] > times[0] ? tokT[i] - times[0] : 0);
          for (int i = 0; i < rawTokens; i++) {
            if (rel[i] != 0xFFFFFFFFUL) continue;
            int pa = i - 1; while (pa >= 0 && rel[pa] == 0xFFFFFFFFUL) pa--;
            int nb = i + 1; while (nb < rawTokens && rel[nb] == 0xFFFFFFFFUL) nb++;
            if (pa >= 0 && nb < rawTokens) rel[i] = rel[pa] + (rel[nb] - rel[pa]) * (uint32_t)(i - pa) / (uint32_t)(nb - pa);
            else if (pa >= 0) rel[i] = rel[pa] + 300UL * (uint32_t)(i - pa);
            else rel[i] = rel[nb] * (uint32_t)i / (uint32_t)nb;
          }
          for (int i = 1; i < rawTokens; i++) if (rel[i] < rel[i - 1]) rel[i] = rel[i - 1];
          wtOff = (uint16_t)wordUsed;
          for (int i = 0; i < rawTokens; i++) wordT[wordUsed++] = (uint16_t)(rel[i] > 65535UL ? 65535UL : rel[i]);
          nw = (uint8_t)rawTokens;
        }
      }
      int need = (int)strlen(tmp) + 1 + (rtl ? 1 : 0);
      if (poolUsed + need > POOL_BYTES) break;
      char *dst = pool + poolUsed;
      if (rtl) { dst[0] = 0x1B; memcpy(dst + 1, tmp, strlen(tmp) + 1); }
      else memcpy(dst, tmp, strlen(tmp) + 1);
      uint16_t off = (uint16_t)poolUsed;
      poolUsed += need;
      for (int i = 0; i < nt && lineCount < MAX_LINES; i++) lines[lineCount++] = {times[i], off, wtOff, nw};
    }
    p = *eol ? eol + 1 : eol;
  }
  for (int i = 1; i < lineCount; i++) {        // insertion sort (already sorted in nearly every file)
    Lyric k = lines[i];
    int j = i - 1;
    while (j >= 0 && lines[j].ms > k.ms) { lines[j + 1] = lines[j]; j--; }
    lines[j + 1] = k;
  }
  return lineCount;
}

// Word-wrap `s` into at most `maxLines` rows of `cols` characters. Returns rows written.
int wrapText(const char *s, int cols, int maxLines, char out[][26]) {
  int rows = 0;
  const char *p = s;
  while (*p == ' ') p++;
  while (*p && rows < maxLines) {
    int len = (int)strlen(p);
    int take = len <= cols ? len : cols;
    if (len > cols) {
      int sp = -1;
      for (int i = cols; i > 0; i--) if (p[i] == ' ') { sp = i; break; }
      if (sp > 0) take = sp;
    }
    if (rows == maxLines - 1 && len > take) {         // last row: cut with a dot
      take = cols;
      memcpy(out[rows], p, (size_t)(take - 1));
      out[rows][take - 1] = '~';
      out[rows][take] = 0;
      return rows + 1;
    }
    memcpy(out[rows], p, (size_t)take);
    out[rows][take] = 0;
    rows++;
    p += take;
    while (*p == ' ') p++;
  }
  return rows;
}
// ---- helpers end

// ---------------------------------------------------------------- state
enum Phase : uint8_t { P_WIFI, P_LOGIN, P_RUN, P_ERROR };
enum Lyr : uint8_t { L_NONE, L_WANT, L_HAVE, L_MISSING };
enum Cmd : uint8_t { C_NONE, C_PLAY, C_PAUSE, C_NEXT, C_PREV };
enum NetWork : uint8_t { NW_NONE, NW_LOGIN, NW_POLL, NW_LYRICS, NW_COMMAND, NW_GENRE };
enum Gen : uint8_t { G_NONE, G_WANT, G_DONE };     // the artist's genres (for the pet's music reactions)

SemaphoreHandle_t stateMutex = nullptr;
TaskHandle_t netTaskHandle = nullptr;
NetWork pendingWork = NW_NONE;
bool workerBusy = false;
uint32_t sessionEpoch = 0;
uint32_t activeWorkEpoch = 0;

bool isOpen = false;
Phase phase = P_WIFI;
char errMsg[40] = "";
uint32_t drawnAt = 0;
bool drawnSince = true;
uint32_t gateUntil = 0;

void lockState() {
  if (stateMutex) xSemaphoreTakeRecursive(stateMutex, portMAX_DELAY);
}
void unlockState() {
  if (stateMutex) xSemaphoreGiveRecursive(stateMutex);
}
struct StateGuard {
  StateGuard() { lockState(); }
  ~StateGuard() { unlockState(); }
};
bool currentWorkLocked() { return isOpen && activeWorkEpoch == sessionEpoch; }

WiFiClientSecure sec;
const char *secHost = "";

char token[512] = "";
uint32_t tokenUntil = 0;       // millis() when the access token stops being valid
bool haveToken = false;
char refreshTok[256] = "";
uint32_t blockedUntil = 0;     // rate limit / failure backoff for every request
uint8_t loginFails = 0;

bool playing = false, haveTrack = false, nothing = false;
char trackId[40] = "";
char title[96] = "", artist[64] = "", album[64] = "", artists[80] = "";   // raw UTF-8 for lookups
char dTitle[96] = "", dArtists[80] = "";                                  // Latin-1 for the screen
uint32_t durMs = 0, progMs = 0, progAt = 0;
uint32_t lastPollRttMs = 0;
uint32_t syncBiasMs = 0;    // extra progress added by the visualizer when the exact timestamp method is unavailable
int lyricOffsetMs = 0;      // Settings > Lyrics sync (+ = lyrics earlier)
uint32_t leftAt = 0;        // when Spotify mode was last left (a quick return keeps the old state) // round-trip time of the last Spotify progress sample
uint32_t nextPoll = 0;
Lyr lyr = L_NONE;
int lyrCode = 0;                // last LRCLIB result (404 = no synced lyrics, <=0 = network/memory trouble)
uint8_t lyrTries = 0;
uint32_t lyrAt = 0;
int curLine = -1;
Cmd cmd = C_NONE;
uint32_t cmdAt = 0;
char note[32] = "";
bool hinted = false;
int drawnTarget = -2, oldTarget = -1;      // lyric line shown last frame / the one sliding out
uint32_t tAt = 0, trackAt = 0;             // when the current line / the current track started to slide in
uint32_t noteUntil = 0;

// ---- what the music is like (the pet reacts to it, see vibe.h)
char artistId[40] = "";
Gen gen = G_NONE;
uint8_t genTries = 0;
uint32_t genAt = 0;
char genreText[96] = "";                    // the artist's genres from Spotify, lower case, joined with ", "
vibe::Vibe vibeGenre = vibe::V_NONE;        // from the genres (V_NONE = Spotify sent none, or none matched)
vibe::Vibe vibeNow = vibe::V_NONE;          // what the pet uses: the genre vibe, else a guess
bool vibeGuessed = true;
int paceX10 = 0;                            // lyric speed, syllables per second x10 (0 = unknown)
bool nonLatin = false;                      // most lyric lines are Urdu / Arabic / Hindi ... script
uint32_t trackSeq = 0;                      // bumps with every new track

// Lyric speed over the time lines are actually sung, and whether the lyrics are mostly non-Latin script.
void lyricStats(int &pace10, bool &nonLat) {
  uint32_t syl = 0, ms = 0;
  int counted = 0, nl = 0;
  for (int i = 0; i < lineCount; i++) {
    const char *s = pool + lines[i].off;
    if (!s[0]) continue;
    uint32_t span = (i + 1 < lineCount ? lines[i + 1].ms : lines[i].ms + 4000) - lines[i].ms;
    if (span < 300) continue;
    if (span > 8000) span = 8000;                        // a long gap is not "slow singing"
    counted++;
    bool rtl = ((unsigned char)s[0]) == 0x1B;            // Urdu / Arabic line (raw UTF-8 after the marker)
    const char *base = rtl ? s + 1 : s;
    int len = (int)strlen(base), q = 0;
    for (const char *c = base; *c; c++) if (*c == '?') q++;   // Hindi etc. turn into '?' in the Latin-1 pool
    if (rtl || (len > 0 && q * 3 >= len)) nl++;
    int ts[lyric_timing::MAX_WORDS], te[lyric_timing::MAX_WORDS];
    int n = tokenize(base, ts, te, lyric_timing::MAX_WORDS);
    for (int w = 0; w < n; w++) syl += rtl ? 2U : (uint32_t)lyric_timing::syllables(base + ts[w], te[w] - ts[w]);
    ms += span;
  }
  pace10 = ms >= 20000 ? (int)(syl * 10000UL / ms) : 0;  // under 20 s of lyrics: not enough to judge
  nonLat = counted > 0 && nl * 10 >= counted * 3;
}

void updateVibeLocked() {                                // call with the state lock held
  if (vibeGenre != vibe::V_NONE) { vibeNow = vibeGenre; vibeGuessed = false; return; }
  vibeNow = vibe::guess(title, artist, nonLatin, paceX10);
  vibeGuessed = true;
}

void setNote(const char *m, uint32_t now) {
  StateGuard guard;
  strncpy(note, m, sizeof(note) - 1);
  note[sizeof(note) - 1] = 0;
  noteUntil = now + 3000;
}

void setError(const char *m) {
  StateGuard guard;
  strncpy(errMsg, m, sizeof(errMsg) - 1);
  errMsg[sizeof(errMsg) - 1] = 0;
  phase = P_ERROR;
}

// ---------------------------------------------------------------- refresh token (SD-free: NVS)
// A refresh token that Spotify rotates is kept in NVS. If you log in again on the PC (a new token in
// secrets.h), the stored one is ignored: "base" remembers the tail of the secrets token it came from.
void loadRefreshToken() {
  StateGuard guard;
  strncpy(refreshTok, SPOTIFY_REFRESH_TOKEN, sizeof(refreshTok) - 1);
  refreshTok[sizeof(refreshTok) - 1] = 0;
  Preferences p;
  if (!p.begin("spotify", true)) return;
  String base = p.getString("base", "");
  String rt = p.getString("rt", "");
  p.end();
  size_t L = strlen(SPOTIFY_REFRESH_TOKEN);
  const char *tail = SPOTIFY_REFRESH_TOKEN + (L > 12 ? L - 12 : 0);
  if (rt.length() > 20 && rt.length() < sizeof(refreshTok) && base == tail) {
    strncpy(refreshTok, rt.c_str(), sizeof(refreshTok) - 1);
    refreshTok[sizeof(refreshTok) - 1] = 0;
  }
}

void saveRefreshToken(const char *rt) {
  Preferences p;
  if (!p.begin("spotify", false)) return;
  size_t L = strlen(SPOTIFY_REFRESH_TOKEN);
  p.putString("base", SPOTIFY_REFRESH_TOKEN + (L > 12 ? L - 12 : 0));
  p.putString("rt", rt);
  p.end();
}

// ---------------------------------------------------------------- HTTP
struct Reply { int code; String body; };

// One TLS client is reused. A request to another host closes it first. Anything but 200 closes the
// connection too, so a half-read 204 can never poison the next request.
Reply request(const char *host, const char *method, const char *path, const char *bearer,
              const char *form, bool wantBody) {
  Reply r{-1, String()};
  uint32_t t0 = millis();
  struct Log {                                                  // one serial line per request: where does the time go?
    Reply &r; const char *host, *path; uint32_t t0;
    ~Log() { if (Serial) Serial.printf("net: %s%.28s -> %d in %lu ms, heap %lu KB\n", host, path, r.code, (unsigned long)(millis() - t0), (unsigned long)(ESP.getFreeHeap() / 1024)); }
  } logger{r, host, path, t0};
  if (strcmp(secHost, host) != 0) { sec.stop(); secHost = host; }   // free the old connection's buffers BEFORE the heap check
  if (ESP.getFreeHeap() < MIN_HEAP) { sec.stop(); secHost = ""; }    // still low: drop even a same-host connection and look again
  if (ESP.getFreeHeap() < MIN_HEAP) { r.code = -2; return r; }
  if (!sec.connected()) {                                           // resolve first: tells "DNS problem" (-6) apart from "TLS/connect problem" (-1)
    IPAddress ip;
    uint32_t d0 = millis();
    bool ok = WiFi.hostByName(host, ip);
    if (Serial) Serial.printf("net: dns %s %s in %lu ms\n", host, ok ? "ok" : "FAILED", (unsigned long)(millis() - d0));
    if (!ok) { r.code = -6; return r; }
  }
  sec.setInsecure();
  char url[360];
  snprintf(url, sizeof(url), "https://%s%s", host, path);
  HTTPClient http;
  http.setReuse(true);
  if (!http.begin(sec, url)) return r;
  http.setConnectTimeout(HTTP_TIMEOUT_MS);
  http.setTimeout(HTTP_TIMEOUT_MS);
  http.setUserAgent("Pocketpet/1.0 (esp32-c3 keychain)");
  if (bearer) {
    char h[560];
    snprintf(h, sizeof(h), "Bearer %s", bearer);
    http.addHeader("Authorization", h);
  }
  if (form) {
    http.addHeader("Content-Type", "application/x-www-form-urlencoded");
    r.code = http.sendRequest(method, String(form));
  } else if (strcmp(method, "GET") == 0) {
    r.code = http.GET();
  } else {
    http.addHeader("Content-Length", "0");     // Spotify answers 411 to a PUT/POST without it
    r.code = http.sendRequest(method, String(""));
  }
  if (r.code < 0 && Serial) {                                       // why did the connection fail? (memory, TLS, timeout)
    char eb[80] = "";
    sec.lastError(eb, sizeof(eb));
    Serial.printf("net: connect error \"%s\" / %s, free %lu KB, largest block %lu KB\n", eb, HTTPClient::errorToString(r.code).c_str(),
                  (unsigned long)(ESP.getFreeHeap() / 1024), (unsigned long)(ESP.getMaxAllocHeap() / 1024));
  }
  if (r.code == 200 && wantBody) {
    int sz = http.getSize();
    if (sz > MAX_BODY) r.code = -3;
    else r.body = http.getString();
  }
  http.end();
  if (r.code != 200) sec.stop();
  return r;
}

// ---------------------------------------------------------------- Spotify calls
bool login(uint32_t now) {
  char form[480];
  {
    StateGuard guard;
    if (!currentWorkLocked()) return false;
    snprintf(form, sizeof(form), "grant_type=refresh_token&refresh_token=%s&client_id=%s", refreshTok, SPOTIFY_CLIENT_ID);
  }
  Reply r = request("accounts.spotify.com", "POST", "/api/token", nullptr, form, true);
  StateGuard guard;
  if (!currentWorkLocked()) return false;
  if (r.code == 400 || r.code == 401) {
    setError("Login expired. Run tools/spotify_auth.py");
    return false;
  }
  if (r.code != 200) {
    if (r.code == -2) setNote("low memory", now);
    blockedUntil = now + (r.code == 429 ? 15000 : 4000);
    return false;
  }
  JsonDocument doc, f;
  f["access_token"] = true; f["expires_in"] = true; f["refresh_token"] = true;
  if (deserializeJson(doc, r.body.c_str(), DeserializationOption::Filter(f))) { blockedUntil = now + 4000; return false; }
  const char *t = doc["access_token"] | "";
  if (!t[0] || strlen(t) >= sizeof(token)) { blockedUntil = now + 4000; return false; }
  strcpy(token, t);
  uint32_t life = doc["expires_in"] | 3600;
  tokenUntil = now + (life > 120 ? life - 90 : life / 2) * 1000UL;
  haveToken = true;
  const char *rt = doc["refresh_token"] | "";
  if (rt[0] && strcmp(rt, refreshTok) != 0 && strlen(rt) < sizeof(refreshTok)) {
    strcpy(refreshTok, rt);
    saveRefreshToken(rt);
  }
  return true;
}
bool tokenOk(uint32_t now) { return haveToken && (int32_t)(tokenUntil - now) > 0; }

void applyTrack(const char *id, const char *t, const char *al, const char *ar, const char *all, uint32_t dur) {
  StateGuard guard;
  strncpy(trackId, id, sizeof(trackId) - 1);
  trackId[sizeof(trackId) - 1] = 0;
  strncpy(title, t, sizeof(title) - 1);   title[sizeof(title) - 1] = 0;
  strncpy(album, al, sizeof(album) - 1);  album[sizeof(album) - 1] = 0;
  strncpy(artist, ar, sizeof(artist) - 1); artist[sizeof(artist) - 1] = 0;
  strncpy(artists, all, sizeof(artists) - 1); artists[sizeof(artists) - 1] = 0;
  strcpy(dTitle, title);   toLatin1(dTitle);
  strcpy(dArtists, artists); toLatin1(dArtists);
  durMs = dur;
  lineCount = 0;
  curLine = -1;
  lyr = L_WANT;
  lyrTries = 0;
  lyrAt = 0;
  drawnTarget = -2;
  oldTarget = -1;
  trackAt = tAt = millis();
  genreText[0] = 0;                                      // a new track: the old genre / lyric speed no longer apply
  vibeGenre = vibe::V_NONE;
  paceX10 = 0;
  nonLatin = false;
  ++trackSeq;
}

void poll(uint32_t now) {
  char accessToken[sizeof(token)];
  {
    StateGuard guard;
    if (!currentWorkLocked()) return;
    strncpy(accessToken, token, sizeof(accessToken) - 1);
    accessToken[sizeof(accessToken) - 1] = 0;
  }
  uint32_t requestAt = millis();
  Reply r = request("api.spotify.com", "GET", "/v1/me/player/currently-playing", accessToken, nullptr, true);
  uint32_t t1 = millis();
  StateGuard guard;
  if (!currentWorkLocked()) return;
  if (r.code == 401) { haveToken = false; return; }
  if (r.code == 429) { blockedUntil = t1 + 15000; nextPoll = t1 + 15000; return; }
  if (r.code == 204) {
    nothing = true; haveTrack = false; playing = false;
    trackId[0] = 0; lineCount = 0; lyr = L_NONE;
    nextPoll = t1 + POLL_PAUSED_MS;
    return;
  }
  if (r.code != 200) {
    nextPoll = t1 + 5000;
    if (r.code == -2) setNote("low memory", t1);
    else if (r.code <= 0 || r.code >= 500) setNote("spotify unreachable", t1);
    return;
  }
  JsonDocument doc, f;
  f["is_playing"] = true;
  f["progress_ms"] = true;
  f["currently_playing_type"] = true;
  f["timestamp"] = true;
  JsonObject fi = f["item"].to<JsonObject>();
  fi["id"] = true; fi["name"] = true; fi["duration_ms"] = true;
  fi["artists"][0]["name"] = true;
  fi["artists"][0]["id"] = true;
  fi["album"]["name"] = true;
  fi["show"]["name"] = true;
  if (deserializeJson(doc, r.body.c_str(), DeserializationOption::Filter(f))) { nextPoll = t1 + 4000; return; }
  lastPollRttMs = t1 - requestAt;
  nothing = false;
  playing = doc["is_playing"] | false;
  progMs = doc["progress_ms"] | 0;
  progAt = t1;
  {
    // Best sync: Spotify says progress_ms was true at "timestamp" (Unix ms). With the clock set by NTP the
    // real position now is progress + (now - timestamp). Without a valid clock fall back to half the round trip.
    syncBiasMs = lastPollRttMs / 2;
    uint64_t ts = doc["timestamp"] | (uint64_t)0;
    struct timeval tv;
    gettimeofday(&tv, nullptr);
    if (playing && ts && tv.tv_sec > 1700000000L) {
      int64_t nowMs = (int64_t)tv.tv_sec * 1000 + tv.tv_usec / 1000;
      int64_t corr = nowMs - (int64_t)ts;
      if (corr >= -1500 && corr <= 10000) {
        if (corr < 0) corr = 0;
        progMs += (uint32_t)corr;
        syncBiasMs = 0;
        if (Serial) Serial.printf("sync: timestamp method, corr %ld ms, rtt %lu ms\n", (long)corr, (unsigned long)lastPollRttMs);
      }
    }
  }
  JsonObjectConst it = doc["item"];
  if (it.isNull()) { haveTrack = false; nothing = true; nextPoll = t1 + POLL_PAUSED_MS; return; }
  const char *id = it["id"] | "";
  const char *name = it["name"] | "";
  const char *al = it["album"]["name"] | (it["show"]["name"] | "");
  const char *ar = it["artists"][0]["name"] | (it["show"]["name"] | "");
  char all[80] = "";
  size_t n = 0;
  for (JsonObjectConst a : it["artists"].as<JsonArrayConst>()) {
    const char *nm = a["name"] | "";
    size_t l = strlen(nm);
    if (n + l + 3 >= sizeof(all)) break;
    if (n) { all[n++] = ','; all[n++] = ' '; }
    memcpy(all + n, nm, l);
    n += l;
    all[n] = 0;
  }
  if (!all[0]) strncpy(all, ar, sizeof(all) - 1);
  uint32_t dur = it["duration_ms"] | 0;
  bool podcast = strcmp(doc["currently_playing_type"] | "track", "track") != 0;
  haveTrack = true;
  if (!hinted) { hinted = true; setNote("A prev  B play  C next", t1); }
  if (strcmp(id, trackId) != 0 || (!id[0] && strcmp(name, title) != 0)) {
    applyTrack(id, name, al, ar, all, dur);
    if (podcast) lyr = L_MISSING;
    const char *aid = it["artists"][0]["id"] | "";
    strncpy(artistId, aid, sizeof(artistId) - 1);
    artistId[sizeof(artistId) - 1] = 0;
    gen = (artistId[0] && !podcast) ? G_WANT : G_DONE;   // ask for the artist's genres next (same connection as this poll)
    genTries = 0;
    genAt = 0;
    updateVibeLocked();                                  // a first guess from the title right away
  }
  nextPoll = t1 + (playing ? POLL_PLAYING_MS : POLL_PAUSED_MS);
}
void sendCommand(uint32_t now) {
  Cmd was = C_NONE;
  char accessToken[sizeof(token)];
  {
    StateGuard guard;
    if (!currentWorkLocked()) return;
    was = cmd;
    if (was == C_NONE) return;
    cmd = C_NONE;
    strncpy(accessToken, token, sizeof(accessToken) - 1);
    accessToken[sizeof(accessToken) - 1] = 0;
  }
  const char *method = "PUT", *path = "/v1/me/player/play";
  if (was == C_PAUSE) path = "/v1/me/player/pause";
  else if (was == C_NEXT) { method = "POST"; path = "/v1/me/player/next"; }
  else if (was == C_PREV) { method = "POST"; path = "/v1/me/player/previous"; }
  Reply r = request("api.spotify.com", method, path, accessToken, nullptr, false);
  uint32_t t1 = millis();
  StateGuard guard;
  if (!currentWorkLocked()) return;
  if (r.code == 401) {
    haveToken = false;
    if (cmd == C_NONE) { cmd = was; cmdAt = t1; }
    return;
  }
  if (r.code == 204 || r.code == 200 || r.code == 202) {
    nextPoll = t1 + (was == C_NEXT || was == C_PREV ? 900 : 600);
    return;
  }
  if (r.code == 403) setNote("needs Premium", t1);
  else if (r.code == 404) setNote("open Spotify on a device", t1);
  else if (r.code == 429) { blockedUntil = t1 + 8000; setNote("slow down", t1); }
  else setNote("command failed", t1);
  if (cmd == C_NONE) {
    if (was == C_PLAY) playing = false;
    else if (was == C_PAUSE) playing = true;
  }
  nextPoll = t1 + 300;
}
// ---------------------------------------------------------------- artist genres (for the pet)
// One small request per new track, on the same connection the poll just used. If Spotify answers with an error or no
// genres the pet simply guesses from the title and the lyrics (vibe::guess); nothing else depends on this.
void fetchGenre(uint32_t now) {
  char id[sizeof(artistId)];
  char accessToken[sizeof(token)];
  {
    StateGuard guard;
    if (!currentWorkLocked() || gen != G_WANT || !artistId[0]) return;
    strncpy(id, artistId, sizeof(id) - 1); id[sizeof(id) - 1] = 0;
    strncpy(accessToken, token, sizeof(accessToken) - 1); accessToken[sizeof(accessToken) - 1] = 0;
  }
  char path[64];
  snprintf(path, sizeof(path), "/v1/artists/%s", id);
  Reply r = request("api.spotify.com", "GET", path, accessToken, nullptr, true);
  uint32_t t1 = millis();
  StateGuard guard;
  if (!currentWorkLocked()) return;
  if (strcmp(id, artistId) != 0) return;                  // the track changed while we asked
  if (r.code == 401) { haveToken = false; return; }       // log in again, then this is asked again
  if (r.code == 429) { blockedUntil = t1 + 15000; return; }
  if (r.code != 200) {
    if (Serial) Serial.printf("genre: artist %s -> %d\n", id, r.code);
    if (r.code == 403 || r.code == 404 || ++genTries >= 2) { gen = G_DONE; updateVibeLocked(); }
    else genAt = t1 + 3000;
    return;
  }
  JsonDocument doc, f;
  f["genres"] = true;
  genreText[0] = 0;
  if (!deserializeJson(doc, r.body.c_str(), DeserializationOption::Filter(f))) {
    size_t n = 0;
    for (JsonVariantConst g : doc["genres"].as<JsonArrayConst>()) {
      const char *gs = g.as<const char *>();
      if (!gs) continue;
      size_t l = strlen(gs);
      if (n + l + 3 >= sizeof(genreText)) break;
      if (n) { genreText[n++] = ','; genreText[n++] = ' '; }
      for (size_t i = 0; i < l; i++) genreText[n++] = (gs[i] >= 'A' && gs[i] <= 'Z') ? (char)(gs[i] + 32) : gs[i];
      genreText[n] = 0;
    }
  }
  vibeGenre = vibe::fromGenres(genreText);
  gen = G_DONE;
  updateVibeLocked();
  if (Serial) Serial.printf("genre: [%s] -> %s%s\n", genreText, vibe::name(vibeNow)[0] ? vibe::name(vibeNow) : "none", vibeGuessed ? " (guessed)" : "");
}

// ---------------------------------------------------------------- lyrics (LRCLIB)
bool lyricsRequest(const char *titleForLookup, const char *artistForLookup,
                   const char *albumForLookup, uint32_t trackDurationMs,
                   bool withAlbum, int &code) {
  {
    StateGuard guard;
    if (!currentWorkLocked()) return false;
  }
  char t[200], a[140], al[140], path[560];
  if (!urlEncode(titleForLookup, t, sizeof(t)) || !urlEncode(artistForLookup, a, sizeof(a)) ||
      !urlEncode(albumForLookup, al, sizeof(al))) { code = -4; return false; }
  int dur = (int)((trackDurationMs + 500) / 1000);
  if (withAlbum) snprintf(path, sizeof(path), "/api/get?artist_name=%s&track_name=%s&album_name=%s&duration=%d", a, t, al, dur);
  else snprintf(path, sizeof(path), "/api/get?artist_name=%s&track_name=%s&duration=%d", a, t, dur);
  Reply r = request("lrclib.net", "GET", path, nullptr, nullptr, true);
  sec.stop();
  secHost = "";
  code = r.code;
  {
    StateGuard guard;
    if (!currentWorkLocked()) return false;
  }
  if (r.code != 200) return false;
  JsonDocument doc, f;
  f["syncedLyrics"] = true;
  if (deserializeJson(doc, r.body.c_str(), DeserializationOption::Filter(f))) { code = -5; return false; }
  r.body = String();
  const char *lrc = doc["syncedLyrics"] | "";
  if (!lrc[0]) { code = 404; return false; }
  StateGuard guard;
  if (!currentWorkLocked()) return false;
  return parseLrc(lrc) >= 2;
}

void fetchLyrics(uint32_t now) {
  char trackTitle[96], trackArtist[64], trackAlbum[64];
  uint32_t trackDurationMs = 0;
  {
    StateGuard guard;
    if (!currentWorkLocked()) return;
    strncpy(trackTitle, title, sizeof(trackTitle) - 1); trackTitle[sizeof(trackTitle) - 1] = 0;
    strncpy(trackArtist, artist, sizeof(trackArtist) - 1); trackArtist[sizeof(trackArtist) - 1] = 0;
    strncpy(trackAlbum, album, sizeof(trackAlbum) - 1); trackAlbum[sizeof(trackAlbum) - 1] = 0;
    trackDurationMs = durMs;
  }
  int code = 0;
  bool ok = lyricsRequest(trackTitle, trackArtist, trackAlbum, trackDurationMs, true, code);
  {
    StateGuard guard;
    if (!currentWorkLocked()) return;
  }
  if (!ok && code == 404) {
    char clean[96];
    cleanTitle(trackTitle, clean, sizeof(clean));
    ok = lyricsRequest(clean, trackArtist, trackAlbum, trackDurationMs, false, code);
  }
  StateGuard guard;
  if (!currentWorkLocked()) return;
  curLine = -1;
  lyrCode = code;
  if (ok) {
    lyr = L_HAVE;
    lyricStats(paceX10, nonLatin);                         // lyric speed + script: what the pet's vibe guess uses
    updateVibeLocked();
    if (Serial) Serial.printf("lyrics: pace %d.%d syl/s, non-latin %d -> %s%s\n", paceX10 / 10, paceX10 % 10, (int)nonLatin,
                              vibe::name(vibeNow)[0] ? vibe::name(vibeNow) : "none", vibeGuessed ? " (guessed)" : "");
    return;
  }
  lineCount = 0;
  if (code == 404) { lyr = L_MISSING; return; }
  if (++lyrTries >= 3) { lyr = L_MISSING; return; }
  lyrAt = now + 2500;
}
// ---------------------------------------------------------------- time helpers
uint32_t position(uint32_t now) {
  uint32_t p = progMs;
  if (playing && haveTrack) p += now - progAt;
  if (durMs && p > durMs) p = durMs;
  return p;
}

void fmtTime(uint32_t ms, char *out) {
  uint32_t s = ms / 1000;
  snprintf(out, 8, "%lu:%02lu", (unsigned long)(s / 60), (unsigned long)(s % 60));
}

// Blocking network operations run on this worker, not on the display/input loop.
// The mutex is held only for short state changes, never during an HTTP request.
void spotifyNetworkTask(void *) {
  for (;;) {
    NetWork work = NW_NONE;
    uint32_t epoch = 0;
    {
      StateGuard guard;
      if (!workerBusy && pendingWork != NW_NONE) {
        work = pendingWork;
        pendingWork = NW_NONE;
        workerBusy = true;
        activeWorkEpoch = sessionEpoch;
        epoch = activeWorkEpoch;
      }
    }
    if (work == NW_NONE) {
      vTaskDelay(pdMS_TO_TICKS(10));
      continue;
    }

    bool run = false;
    {
      StateGuard guard;
      run = isOpen && epoch == sessionEpoch;
    }
    if (run) {
      switch (work) {
        case NW_LOGIN: {
          bool ok = login(millis());
          StateGuard guard;
          if (currentWorkLocked()) {
            if (ok) {
              phase = P_RUN;
              loginFails = 0;
              nextPoll = millis();
            } else if (phase != P_ERROR && ++loginFails >= 6) {
              setError("Cannot reach Spotify");
            }
          }
          break;
        }
        case NW_POLL:    poll(millis()); break;
        case NW_LYRICS:  fetchLyrics(millis()); break;
        case NW_GENRE:   fetchGenre(millis()); break;
        case NW_COMMAND: sendCommand(millis()); break;
        default: break;
      }
    }

    bool stale = false;
    {
      StateGuard guard;
      stale = !isOpen || epoch != sessionEpoch;
      workerBusy = false;
      if (!stale) {
        drawnSince = false;
        gateUntil = millis() + 250;
      }
    }
    // The TLS client belongs to this task. Clean it up here rather than racing leave().
    if (stale) {
      sec.stop();
      secHost = "";
    }
    vTaskDelay(pdMS_TO_TICKS(1));
  }
}

bool ensureNetworkWorker() {
  if (!stateMutex) stateMutex = xSemaphoreCreateRecursiveMutex();
  if (!stateMutex) return false;
  if (!netTaskHandle) {
    // Keep the TLS stack off loop(); give it the same generous stack budget it used before.
    BaseType_t result = xTaskCreate(spotifyNetworkTask, "spotifyNet", 16384, nullptr, 1, &netTaskHandle);
    if (result != pdPASS) {
      netTaskHandle = nullptr;
      return false;
    }
  }
  return true;
}

}  // namespace

// ================================================================ public API
bool active() {
  StateGuard guard;
  return isOpen;
}

// A read-only snapshot for the separate lyrics visualizer. The established Spotify renderer
// remains independent: this function only copies data while holding the state mutex.
void setLyricOffset(int ms) { lyricOffsetMs = ms; }

bool getLyricsView(LyricsView &out, uint32_t now) {
  memset(&out, 0, sizeof(out));
  out.focusWord = -1;
  StateGuard guard;
  drawnSince = true;                                   // the visualizer counts as the frame that lets the next request start
  out.haveTrack = haveTrack;
  out.playing = playing;
  {                                                    // one line the visualizer can show as the "what is it doing" indicator
    const char *st = "";
    bool busy = true;
    if (phase == P_ERROR) { st = errMsg; busy = false; }
    else if (phase == P_WIFI) st = online::wifiStatusText();
    else if (phase == P_LOGIN) st = "logging in";
    else if (!haveTrack && nothing) { st = "nothing playing"; busy = false; }
    else if (!haveTrack) st = "asking spotify";
    else if (lyr == L_WANT) st = "finding lyrics";
    else if (lyr == L_MISSING) {
      busy = false;
      if (lyrCode == 404) st = "no synced lyrics";
      else { snprintf(out.status, sizeof(out.status), "lyrics failed (%d)", lyrCode); st = out.status; }   // -2 = low memory, -1 = no answer
    }
    else busy = false;
    if (st != out.status) strncpy(out.status, st, sizeof(out.status) - 1);
    out.statusBusy = busy && st[0];
  }
  // Spotify's progress_ms is sampled during the HTTP request, not when the
  // response reaches the ESP32. The normal renderer keeps its established
  // timing, but the independent visualizer uses a midpoint RTT correction.
  // This removes most of the visible network-latency offset without touching
  // the original Spotify renderer.
  out.positionMs = position(now);
  if (playing && haveTrack) {
    out.positionMs += syncBiasMs;
    if (durMs && out.positionMs > durMs) out.positionMs = durMs;
  }
  {                                                    // user fine-tuning from Settings
    int64_t p = (int64_t)out.positionMs + lyricOffsetMs;
    out.positionMs = p < 0 ? 0 : (uint32_t)p;
  }
  out.durationMs = durMs;
  if (!haveTrack || lyr != L_HAVE || lineCount <= 0) return true;

  // The visualizer is drawn locally at frame rate, so it does not need the
  // old renderer's 300 ms lyric lead. Use the actual playback position.
  const uint32_t targetTime = out.positionMs;
  int target = -1;
  for (int i = 0; i < lineCount && lines[i].ms <= targetTime; ++i) target = i;
  if (target < 0 || !pool[lines[target].off]) {        // intro or a blank line: keep the visualizer alive, it shows a "break" state
    out.inGap = true;
    out.gapStartMs = target < 0 ? 0 : lines[target].ms;
    out.gapEndMs = target + 1 < lineCount ? lines[target + 1].ms : (durMs > out.gapStartMs ? durMs : out.gapStartMs + 4000);
    return true;
  }

  out.lyricsReady = true;
  strncpy(out.line, pool + lines[target].off, sizeof(out.line) - 1);
  out.lineStartMs = lines[target].ms;
  out.lineEndMs = target + 1 < lineCount ? lines[target + 1].ms : lines[target].ms + 4000;
  out.focusWord = wordFocus(target, (int32_t)targetTime - (int32_t)out.lineStartMs, out.lineEndMs - out.lineStartMs);
  if (target + 1 < lineCount && pool[lines[target + 1].off]) {
    strncpy(out.nextLine, pool + lines[target + 1].off, sizeof(out.nextLine) - 1);
  }
  return true;
}

// Read-only snapshot for the pet (Pet mode with Settings > Music pet). Works with only a background session open: nothing
// is drawn by Spotify mode, so this counts as "the frame was drawn" that lets the next request start.
bool getMusic(vibe::Music &out, uint32_t now) {
  memset(&out, 0, sizeof(out));
  out.word = -1;
  StateGuard guard;
  if (!isOpen) return false;
  drawnSince = true;
  if (!haveTrack || !playing) return false;
  out.active = true;
  out.vibe = vibeNow;
  out.guessed = vibeGuessed;
  out.energy = (uint8_t)vibe::energyFor(paceX10);
  out.beatMs = (uint16_t)(60000 / vibe::bpmFor(vibeNow, paceX10));
  out.positionMs = position(now);
  out.trackSeq = trackSeq;
  if (lyr == L_HAVE && lineCount > 0) {
    uint32_t t = out.positionMs;
    int target = -1;
    for (int i = 0; i < lineCount && lines[i].ms <= t; ++i) target = i;
    if (target >= 0 && pool[lines[target].off]) {
      uint32_t end = target + 1 < lineCount ? lines[target + 1].ms : lines[target].ms + 4000;
      out.singing = true;
      out.word = (int16_t)wordFocus(target, (int32_t)t - (int32_t)lines[target].ms, end - lines[target].ms);
    }
  }
  return true;
}

void enter() {
  if (!ensureNetworkWorker()) {
    StateGuard guard;
    ++sessionEpoch;
    isOpen = true;
    setError("Network task unavailable");
    return;
  }
  bool acquireWifi = false;
  uint32_t nowMs = millis();
  // Warm return: you left Spotify / Lyrics visual a moment ago, Wi-Fi is still up and the token is valid.
  // Both modes share one session, so switching between them keeps the track, the lyrics and the connection.
  bool warm = configured && online::wifiUp() && haveTrack && tokenOk(nowMs) && (nowMs - leftAt) < 45000;
  {
    StateGuard guard;
    ++sessionEpoch;
    isOpen = true;
    phase = warm ? P_RUN : P_WIFI;
    errMsg[0] = 0;
    if (!warm) {
      haveTrack = false;               // the access token (RAM only, valid ~1 h) is kept: re-entering skips the login
      nothing = false;
      playing = false;
      trackId[0] = 0;
      lineCount = 0;
      lyr = L_NONE;
    }
    cmd = C_NONE;
    note[0] = 0;
    hinted = false;
    blockedUntil = 0;
    nextPoll = 0;                      // ask Spotify right away (also resyncs a warm return)
    loginFails = 0;
    pendingWork = NW_NONE;
    drawnSince = true;
    gateUntil = 0;
    if (!configured) setError("Add Spotify keys to secrets.h");
    else if (!online::wifiConfigured()) setError("No Wi-Fi in secrets.h");
    else {
      loadRefreshToken();
      acquireWifi = true;
    }
  }
  if (acquireWifi) online::wifiAcquire(millis());
}

void leave() {
  {
    StateGuard guard;
    isOpen = false;
    ++sessionEpoch;
    pendingWork = NW_NONE;
    leftAt = millis();                 // the track and lyrics are kept for a warm return
  }
  // Do not stop sec here: an in-flight worker request owns that client.
  online::wifiRelease();                // Wi-Fi lingers ~45 s inside online.cpp
}

void tick(uint32_t now) {
  bool wifiUp = online::wifiUp();
  StateGuard guard;
  if (!isOpen || phase == P_ERROR) return;
  if (!wifiUp) {
    if (!workerBusy && pendingWork == NW_NONE) phase = P_WIFI;
    return;
  }
  if (phase == P_WIFI) { phase = P_LOGIN; blockedUntil = now + 150; }
  if (!drawnSince && (int32_t)(now - gateUntil) < 0) return;
  if ((int32_t)(now - blockedUntil) < 0) return;

  if (!tokenOk(now)) {
    if (phase == P_RUN) phase = P_LOGIN;
    if (!workerBusy && pendingWork == NW_NONE) pendingWork = NW_LOGIN;
    return;
  }
  phase = P_RUN;

  if (cmd != C_NONE && (int32_t)(now - cmdAt) >= 0) {
    if (!workerBusy && pendingWork == NW_NONE) pendingWork = NW_COMMAND;
    return;
  }
  if (gen == G_WANT && (int32_t)(now - genAt) >= 0 && haveTrack) {      // before the lyrics: still on the Spotify connection
    if (!workerBusy && pendingWork == NW_NONE) pendingWork = NW_GENRE;
    return;
  }
  if (lyr == L_WANT && (int32_t)(now - lyrAt) >= 0 && haveTrack && durMs) {
    if (!workerBusy && pendingWork == NW_NONE) pendingWork = NW_LYRICS;
    return;
  }
  if ((int32_t)(now - nextPoll) >= 0) {
    if (!workerBusy && pendingWork == NW_NONE) pendingWork = NW_POLL;
  }
}

static void inputLocked(bool a, bool b, bool c, uint32_t now) {
  if (!isOpen) return;
  if (phase == P_ERROR) {
    if (b && configured && online::wifiConfigured() && strstr(errMsg, "Cannot")) {
      errMsg[0] = 0; phase = P_WIFI; loginFails = 0; online::wifiAcquire(now);
    }
    return;
  }
  if (phase != P_RUN) { if (b) online::wifiAcquire(now); return; }
  if (nothing && !haveTrack) {
    if (b) { cmd = C_PLAY; cmdAt = now; setNote("resuming...", now); }
    return;
  }
  if (b) {
    cmd = playing ? C_PAUSE : C_PLAY;
    cmdAt = now;
    progMs = position(now); progAt = now;
    playing = !playing;
  } else if (c) {
    cmd = C_NEXT; cmdAt = now; setNote("next >>", now);
  } else if (a) {
    cmd = C_PREV; cmdAt = now; setNote("<< previous", now);
  }
}

void input(bool a, bool b, bool c, uint32_t now) {
  StateGuard guard;
  inputLocked(a, b, c, now);
}

// ---------------------------------------------------------------- drawing
namespace {

void centered(U8G2 &d, int y, const char *s) {
  int w = d.getStrWidth(s);
  d.drawStr(w >= 128 ? 0 : (128 - w) / 2, y, s);
}

void drawStatus(U8G2 &d, const char *l1, const char *l2, const char *l3) {
  d.setFont(u8g2_font_7x13B_tf);
  centered(d, 14, "SPOTIFY");
  d.drawHLine(0, 17, 128);
  d.setFont(u8g2_font_6x10_tf);
  if (l1) centered(d, 33, l1);
  if (l2) centered(d, 45, l2);
  d.setFont(u8g2_font_5x7_tf);
  if (l3) centered(d, 62, l3);
}

void drawMarquee(U8G2 &d, const char *s, int baseline, uint32_t now, int shift, int maxW) {
  int w = d.getStrWidth(s);
  if (w <= maxW) { d.drawStr(shift, baseline, s); return; }
  int span = w + 24;
  int off = (int)((now / 45) % (uint32_t)span);
  d.drawStr(shift - off, baseline, s);
  d.drawStr(shift + span - off, baseline, s);
}

void trimTo(U8G2 &d, const char *s, char *out, size_t cap, int maxW) {   // cut with "~" so it fits maxW pixels
  strncpy(out, s, cap - 1);
  out[cap - 1] = 0;
  size_t n = strlen(out);
  if (d.getStrWidth(out) <= maxW) return;
  while (n > 1 && d.getStrWidth(out) + d.getStrWidth("~") > maxW) out[--n] = 0;
  if (n < cap - 1) { out[n] = '~'; out[n + 1] = 0; }
}


// ---- animation helpers
int easeOut(uint32_t elapsed, uint32_t dur) {          // 0..1000, fast start and soft landing
  if (elapsed >= dur) return 1000;
  int32_t inv = 1000 - (int32_t)(elapsed * 1000UL / dur);
  return 1000 - inv * inv * inv / 1000000;
}

// Equalizer in the top-right corner: bounces while playing, flat bars when paused.
void drawEq(U8G2 &d, int x, uint32_t now, bool play) {
  static const uint8_t ph[4] = {0, 5, 11, 3};
  for (int i = 0; i < 4; i++) {
    int h = 1;
    if (play) {
      int t = (int)((now / 75 + ph[i] * 7) % 16);
      h = 1 + (t < 8 ? t : 15 - t) * 6 / 7;
    }
    d.drawBox(x + i * 3, 8 - h, 2, h);
  }
}

void drawDots(U8G2 &d, uint32_t now, int xShift) {      // bouncing dots for instrumental parts
  for (int i = 0; i < 3; i++) {
    int t = (int)((now / 90 + i * 5) % 16);
    int up = t < 8 ? t : 15 - t;
    d.drawDisc(54 + i * 10 + xShift, 34 - up / 2, 2);
  }
}

// One big lyric line, centered, wrapped to 2 rows. focusWord = index of the word being sung (see wordFocus()),
// -1 = no focus effect (old line leaving, or plain title). The focused word is drawn inverted.
// Urdu / Arabic line (stored with a leading 0x1B): shaped, right-to-left, up to 2 rows of 16 glyphs.
// The focus word is inverted, the first word of the line is on the right.
void drawBigRtl(U8G2 &d, const char *utf8, int xShift, int focusWord) {
  arabic::Row rows[2];
  int totalWords = 0;
  int n = arabic::layoutRows(utf8, arabic::MAX_COLS, 2, rows, &totalWords);
  if (n == 0) return;
  int shown = 0;
  for (int r = 0; r < n; r++) shown += rows[r].nWords;
  int focus = (focusWord < 0 || shown == 0) ? -1 : (focusWord >= shown ? shown - 1 : focusWord);
  d.setFont(u8g2_font_unifont_t_urdu);
  for (int r = 0; r < n; r++) {
    int base = n == 1 ? 38 : 28 + r * 16;
    int w = arabic::rowWidth(d, rows[r].g, rows[r].n);
    int x0 = (128 - w) / 2 + xShift;
    arabic::drawGlyphs(d, x0, base, rows[r].g, rows[r].n);
    for (int k = 0; k < rows[r].nWords; k++) {
      if (rows[r].words[k].idx != focus) continue;
      int wx = x0 + arabic::rowWidth(d, rows[r].g, rows[r].words[k].start);
      int ww = arabic::rowWidth(d, rows[r].g + rows[r].words[k].start, rows[r].words[k].len);
      d.setDrawColor(2);                                    // XOR: inverts the word in place
      d.drawBox(wx - 1, base - 11, ww + 2, 14);
      d.setDrawColor(1);
    }
  }
}

void drawBig(U8G2 &d, const char *text, int xShift, int focusWord) {
  if (text[0] == 0x1B) { drawBigRtl(d, text + 1, xShift, focusWord); return; }
  int len = (int)strlen(text);
  int tier = len <= 18 ? 0 : (len <= 40 ? 1 : 2);        // bold 7x13, normal 6x10, small 5x7 (up to 3 rows)
  d.setFont(tier == 0 ? u8g2_font_7x13B_tf : (tier == 1 ? u8g2_font_6x10_tf : u8g2_font_5x7_tf));
  const int fw = tier == 0 ? 7 : (tier == 1 ? 6 : 5);
  const int cols = 128 / fw;                              // 18, 21 or 25 characters per row
  const int asc = tier == 0 ? 10 : (tier == 1 ? 8 : 6);
  const int bh = tier == 0 ? 13 : (tier == 1 ? 11 : 8);
  const int maxRows = tier == 2 ? 3 : 2;
  char row[3][26];
  int n = wrapText(text, cols, maxRows, row);
  int wordNo = 0;                                         // running word index over all rows
  for (int r = 0; r < n; r++) {
    int L = (int)strlen(row[r]);
    int base = tier == 2 ? 23 + r * 11 : (n == 1 ? 34 : 27 + r * 13);
    int x0 = (128 - L * fw) / 2 + xShift;
    for (int i = 0; i < L;) {
      if (row[r][i] == ' ') { i++; continue; }
      int j = i;
      while (j < L && row[r][j] != ' ') j++;
      char w[26];
      memcpy(w, row[r] + i, (size_t)(j - i));
      w[j - i] = 0;
      int x = x0 + i * fw;
      bool focus = focusWord >= 0 && wordNo == focusWord;
      wordNo++;
      if (focus) {
        d.drawBox(x - 1, base - asc, (j - i) * fw + 2, bh);
        d.setDrawColor(0);
        d.drawStr(x, base, w);
        d.setDrawColor(1);
      } else {
        d.drawStr(x, base, w);
      }
      i = j;
    }
  }
}

void drawSmall(U8G2 &d, const char *s, int base, int xShift) {
  char buf[40];
  d.setFont(u8g2_font_5x7_tf);
  trimTo(d, s, buf, sizeof(buf), 128);
  d.drawStr((128 - d.getStrWidth(buf)) / 2 + xShift, base, buf);
}

// A quiet, labelled preview keeps it visually distinct from the main karaoke line.
void drawNextPreview(U8G2 &d, const char *s, int base, int xShift) {
  char buf[40];
  d.setFont(u8g2_font_5x7_tf);
  trimTo(d, s, buf, sizeof(buf), 100);
  d.drawStr(2, base, "NEXT");
  const int left = 23;
  const int width = 103;
  d.drawStr(left + (width - d.getStrWidth(buf)) / 2 + xShift, base, buf);
}

}  // namespace

static void drawLocked(U8G2 &d, uint32_t now) {
  drawnSince = true;
  d.setFontPosBaseline();
  if (phase == P_ERROR) {
    char row[3][26];
    int n = wrapText(errMsg, 21, 3, row);
    d.setFont(u8g2_font_7x13B_tf);
    centered(d, 14, "SPOTIFY");
    d.drawHLine(0, 17, 128);
    d.setFont(u8g2_font_6x10_tf);
    for (int i = 0; i < n; i++) centered(d, 32 + i * 11, row[i]);
    if (strstr(errMsg, "Cannot")) { d.setFont(u8g2_font_5x7_tf); centered(d, 62, "B retry  Hold B=Home"); }
    else { d.setFont(u8g2_font_5x7_tf); centered(d, 62, "Hold B = Home"); }
    return;
  }
  if (phase == P_WIFI) { drawStatus(d, online::wifiStatusText(), "...", "B retry  Hold B=Home"); return; }
  if (phase == P_LOGIN) { drawStatus(d, "logging in", "to Spotify...", "Hold B = Home"); return; }
  if (!haveTrack) {
    drawStatus(d, nothing ? "Nothing playing" : "Asking Spotify...", nothing ? "B = resume" : "", "open Spotify on a device");
    if (note[0] && (int32_t)(noteUntil - now) > 0) { d.setFont(u8g2_font_5x7_tf); d.setDrawColor(0); d.drawBox(0, 54, 128, 10); d.setDrawColor(1); centered(d, 62, note); }
    return;
  }

  d.setFontMode(1);                                   // transparent text, needed for the inverted focus word
  uint32_t pos = position(now);
  bool noteOn = note[0] && (int32_t)(noteUntil - now) > 0;
  int inTrack = 1000 - easeOut(now - trackAt, 380);   // 1000 -> 0: header and title slide in from the right
  int trackShift = inTrack * 128 / 1000;

  // top bar: "title - artists" (scrolls when long) and the equalizer
  char head[180];
  snprintf(head, sizeof(head), "%s - %s", dTitle, dArtists);
  d.setFont(u8g2_font_5x7_tf);
  d.setClipWindow(0, 0, 112, 9);
  drawMarquee(d, head, 7, now, trackShift, 112);
  d.setMaxClipWindow();
  drawEq(d, 117, now, playing);
  d.drawHLine(0, 10, 128);                         // quiet divider under the metadata row

  if (lyr == L_HAVE && lineCount > 0) {
    int target = -1;                                  // last line whose time has come
    int p = (int)pos + LYRIC_LEAD_MS + lyricOffsetMs;
    int i = curLine >= 0 && curLine < lineCount && (int)lines[curLine].ms <= p ? curLine : 0;
    for (; i < lineCount && (int)lines[i].ms <= p; i++) target = i;
    curLine = target;
    if (target != drawnTarget) {                      // new line: the old one slides out to the left
      oldTarget = (drawnTarget >= 0 && drawnTarget < lineCount) ? drawnTarget : -1;
      drawnTarget = target;
      tAt = now;
    }
    int e = easeOut(now - tAt, 320);
    int inShift = (1000 - e) * 128 / 1000;            // new line: +128 -> 0 (from the right)
    int outShift = -e * 128 / 1000;                   // old line: 0 -> -128
    bool moving = e < 1000;

    if (moving && oldTarget >= 0 && pool[lines[oldTarget].off]) drawBig(d, pool + lines[oldTarget].off, outShift, -1);
    else if (moving && oldTarget >= 0) drawDots(d, now, outShift);

    if (target < 0 || !pool[lines[target].off]) {
      drawDots(d, now, inShift);                      // intro or instrumental gap
    } else {
      const char *txt = pool + lines[target].off;
      uint32_t ls = lines[target].ms;
      uint32_t span = target + 1 < lineCount ? lines[target + 1].ms - ls : 4000;
      int f = wordFocus(target, p - (int)ls, span);
      drawBig(d, txt, inShift, f);
    }
    if (!noteOn && target >= 0 && strlen(pool + lines[target].off) <= 40 && pool[lines[target].off] != 0x1B &&
        target + 1 < lineCount && pool[lines[target + 1].off] && pool[lines[target + 1].off] != 0x1B) {
      d.drawHLine(0, 49, 128);                       // separate main lyric from its preview
      drawNextPreview(d, pool + lines[target + 1].off, 58, inShift);
    }
  } else {
    drawBig(d, dTitle, trackShift, -1);               // no synced lyrics: just the song, nicely centered
    d.setFont(u8g2_font_5x7_tf);
    int n = (int)strlen(dTitle) <= 18 ? 1 : 2;
    drawSmall(d, dArtists, n == 1 ? 50 : 56, trackShift);
    if (lyr == L_WANT && !noteOn) {                   // "finding lyrics" with a little dot animation
      char f[24];
      snprintf(f, sizeof(f), "finding lyrics%.*s", (int)((now / 300) % 4), "...");
      d.drawStr((128 - d.getStrWidth("finding lyrics...")) / 2, 60, f);
    }
  }

  // time and notes only appear after a button press; otherwise a single thin progress line
  d.setFont(u8g2_font_5x7_tf);
  if (noteOn) {
    char t1[8], t2[8];
    fmtTime(pos, t1);
    fmtTime(durMs, t2);
    d.setDrawColor(0);
    d.drawBox(0, 51, 128, 12);
    d.setDrawColor(1);
    d.drawStr(0, 60, t1);
    d.drawStr(128 - d.getStrWidth(t2), 60, t2);
    char nb[32];
    trimTo(d, note, nb, sizeof(nb), 84);
    d.drawStr((128 - d.getStrWidth(nb)) / 2, 60, nb);
  }
  if (durMs) {
    int w = (int)((uint64_t)pos * 127 / durMs);
    for (int x = 0; x < 128; x += 3) d.drawPixel(x, 63);  // dotted unplayed rail
    d.drawHLine(0, 63, w);                               // solid elapsed portion
    d.drawVLine(w, 60, 4);                               // small playhead marker
  }
  d.setFontMode(0);
}

void draw(U8G2 &d, uint32_t now) {
  StateGuard guard;
  drawLocked(d, now);
}

}  // namespace spotify
