Salmon10k/Pocketpet.esp32c3/(commit log)

2026-10-09 Add boot timing log, serial pin diagnostics, OLED wait and re-init
    Claude-Session: https://claude.ai/code/session_01KG8z6erNz35kpGsUWn3ouC
2026-10-09 Move OLED to separate software I2C pins
2026-10-09 Use software I2C for OLED and hardware I2C for MPU6050
2026-10-09 Document current OLED and MPU6050 I2C architecture
2026-10-09 Fix button debounce and press event handling
    [main.cpp]
2026-10-10 Swap I2C roles, move touch to GPIO4, and rebuild pet mode
    - OLED now uses hardware I2C (GPIO 8/9, 400 kHz); MPU6050 uses SoftWire (GPIO 5/6)
    - Touch pad moved to GPIO4 to match the real wiring
    - OLED presence is now detected and re-initialised if it drops out
    - New pet mode: mood system, eased eyes, idle wandering, blink/wink,
    tap/purr touch petting with hearts, dizzy/surprised/laugh reactions,
    sleepy and sleeping states with Zzz
    - Happiness/energy/pet count saved to flash, new Stats screen
    - README and config.h updated for the new bus layout and tuning knobs
    Claude-Session: https://claude.ai/code/session_013EpLsZUXrmRq4rnUXXXrz8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
    [config.h, main.cpp]
2026-10-10 Batch 1: add Tools/Games/Online menus plus Temperature, Magic 8-ball, and Dice
2026-10-10 Show touch Home shortcut in menu footer
    [main.cpp]
2026-10-10 Record Batch 1 hardware confirmation and current test status
2026-10-10 Fix generated maze movement and move counter
    [main.cpp]
2026-10-10 Fix clock setup hint for local secrets file
    [main.cpp]
2026-10-10 Fix duplicate maze and Dino game definitions
    [main.cpp]
2026-10-10 Fluid: slower Honey, faster Mercury, new gyro-driven Splash preset
    Claude-Session: https://claude.ai/code/session_013EpLsZUXrmRq4rnUXXXrz8
2026-10-10 Splash: fix inverted feel, real gyro shake/spin, add FLUID_FLIP_X/Y
    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
    [config.h, fluid.cpp, fluid.h, main.cpp]
2026-10-10 Add Settings menu: brightness, screen auto-off, flip screen, reset pet
    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
    [main.cpp]
2026-10-11 Add Online mode: 12 internet screens with Wi-Fi power management
    New src/online.h/.cpp (self-contained): Wi-Fi stays off until a screen needs it,
    one blocking request per tick after a "Fetching..." frame, RAM cache with age tags,
    radio off 6 s after the last request. Screens: Clock (NTP, keeps ticking offline),
    Weather, 5-day Forecast, Air quality, Currency, World clocks (own DST rules), Random
    fact, Advice, Moon phase, Net status, ISS tracker, GitHub stats. Location comes from
    an IP lookup unless set in secrets.h. Pet mode shows tiny corner icons (hot, rain,
    smog, night) from cached data and gets +1 happiness per successful fetch; drawPet()
    is unchanged.
    main.cpp: old Wi-Fi clock removed,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
2026-10-11 Fix build: rename bit() helper that clashed with Arduino's bit() macro
    online.cpp defined its own bit(); Arduino.h #defines bit(b), so the C3 build failed.
    Renamed to jbit(). Host-check Arduino.h mock now defines bit/bitRead/sq/lowByte/highByte
    so this class of clash is caught before flashing.
    Claude-Session: https://claude.ai/code/session_01PhqhLCt7A9Aq3vJbPvr8w3
2026-10-11 Online: one Wi-Fi session per visit, auto-retry connect and requests
    Entering Online now connects once, fetches everything for every screen in one go
    (ordered, with sync progress in the list header) and stays connected while browsing;
    leaving Online turns the radio off. Per-screen connecting is gone.
    Reliability: 3 automatic connect attempts with backoff, DHCP settle delay, transient
    request failures retried up to 3 times, link-drop auto reconnect, lower default TX power
    (8.5 dBm, WIFI_TX_POWER override in secrets.h) which is the usual fix for flaky
    ESP32-C3 Super Mini Wi-Fi. List gains "Sync now". Net status and ISS refresh only
    while open. README, HANDOFF, secrets.example.h updated. Host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
2026-10-11 Give the app a 3 MB flash slot and print memory numbers
    Online mode pushed the firmware to ~79% of the default 1.3 MB app slot. Add
    partitions.csv (one 3 MB app slot, no OTA, nvs unchanged so saved stats survive) and
    point platformio.ini at it. Boot log now prints app size / free app space / heap, and
    Online prints heap after each sync. Host mocks extended (ESP). Docs updated.
    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
2026-10-11 Online: support several Wi-Fi networks (home, uni, hotspot)
    secrets.h can define WIFI_NETWORKS { {ssid, pass}, ... }; the single WIFI_SSID /
    WIFI_PASSWORD setup keeps working. With several networks Online does an async scan,
    orders the known ones by signal strength and gives each two connect attempts before
    failing. Net status shows the connected network name and signal. Host-check mocks,
    README, HANDOFF and secrets.example.h updated; ordering logic tested on the host.
    Not yet tested on the device.
    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
2026-10-11 Spotify: animated lyrics screen
    - lines slide in from the right (ease-out) while the old one slides out left
    - focused word is highlighted (inverted) and a bar under the line fills as it is sung
    (word timing estimated from line length, LRC only has line times)
    - bouncing dots for intros and instrumental gaps
    - cleaner layout: one top bar with a small equalizer, big centered line,
    small next-line preview, thin progress line; time and hints only after a button press
    - long lines drop to smaller fonts (up to 3 rows); no-lyrics view shows title and artist
    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
2026-10-11 Wire standalone lyrics visualizer into menu
2026-10-11 Keep sync correction valid only for successful progress samples
2026-10-13 Swap logical A and B button pins
2026-10-13 Correct button mapping: swap A and C
2026-10-13 Living OLED: always draw (main clears the buffer every frame)
    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
2026-10-30 Pause project: status notes and PCB design files
    Mark the project as paused in README.md and HANDOFF.md with the state at pause and how to resume.
    Add pcb/ with the ghost board outline SVG, the KiCad placement script and notes on the unfinished PCB.
    Docs and design files only, no firmware changes.
    Claude-Session: https://claude.ai/code/session_019J3Toyd8Vg7mD1Gtd4iGBn
2026-11-09 Put the OLED and MPU6050 on one shared hardware I2C bus (GPIO 8/9)
    Drops SoftWire and AsyncDelay, the MPU6050 now uses Wire like the OLED. GPIO 5/6 are free.
    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
2026-11-12 Games + menu revamp: 4 new games, every sub-menu in the launcher look
    Games (src/games.cpp, built for 3 buttons + MPU6050):
    - Star Blaster: tilt-flown side shooter, rapid fire, smart bomb, power-ups
    - Sniper: tilt-aimed scope with sway, bolt action, hold C to steady + zoom
    - Road Rush: pseudo-3D racer, tilt steering, nitro/brake, checkpoints
    - Pinball: sideways table, A/C flippers, shake to nudge, TILT penalty
    - Snake now steers by tilt too (no U-turns); 8-ball/Dice moved to Tools and react to a shake
    - Flappy, Dino Runner and Catch Water removed
    - Best scores saved in NVS
    Menus: launcher::enterSub() draws any list in the carousel / tilt-ring look.
    Tools, Games, Settings and the Online list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
2026-11-14 Review fixes: Stats system page, CI build, doc fixes
    - Stats screen: A/C flips to a System page (FPS, loop rate, free/min heap,
    largest free block, app size, uptime, reset reason); serial status line
    now prints fps and heap numbers too.
    - Add GitHub Actions workflow: PlatformIO firmware build with RAM/flash
    summary and firmware.bin artifact, plus the host syntax check.
    - README/HANDOFF: button pins match config.h (A=GPIO2, C=GPIO0), refresh the
    stale PAUSED banner, explain the missing pcb/README.md, fix the literal \n
    in the README checklist, update memory numbers (RAM 31.7%, flash 36.0%).
    Claude-Session: https://claude.ai/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
